gryxay/Rover/doc/presentations/presentation_4.pptx

## VILNIUS UNIVERSITY, FACULTY OF MATHEMATICS AND INFORMATICS, INFORMATION TECHNOLOGIES STUDY PROGRAMME

2022-12-01 Rover, VU, MIF

Rover

Done by:
Gabrielius Drungilas
Aistė Grigalūnaitė
Nedas Janušauskas
Adomas Jonavičius
Supervisor: Linas Bukauskas

## Outline

- Problem
- Accomplishments
- New parts
- Current status
- Upcoming goals

2022-12-01 Rover, VU, MIF

## Problems

Problem:
- Uneven turning angles on different surfaces due to slippage
Solution:
- Fixed tracks belt
- Accelerometer / gyroscope sensor and magnetometer

## Accomplishments

- Bought accelerometer / gyroscope sensor
- Bought magnetometer

## New parts

- Currently we are doing testing
Problems
- It is disturbet by the magnetic fields of electronics and batteries.
- Does not always show accurately

## Current Status

- 484 hours spent on the project.
- Working on:
- Calibration and testing of new parts
- Room mapping system
- Computer vision

## Upcoming Goals

- Work on mapping system
- Add fully functional accelerometer / gyroscope sensor and magnetometer.

## THANK YOU FOR YOUR ATTENTION

## QUESTIONS?
