gryxay/Rover/doc/weekly_reports/weekly_report_10.pdf

# Weekly report 10

What was done this week?

- Bought, tested and calibrated a compass.
- Fixed small issues.
- Created project abstract.
- Programming classes with python.
- Developing precise movement while using compass.
- Testing.
- Writing a weekly report ฀.

What issues/risks/blockers do you have?

- Currently, we don’t have any issues.

What is the goal for next week?

- Keep working on object detection / computer vision.
- Keep working on room mapping system.
- Try to fully implement compass to our project.

What is the overall status?

- Green.
