gryxay/Rover/doc/weekly_reports/weekly_report_3.pdf

# Weekly report 3

What was done this week?

- Buying the required hardware.
- Testing the hardware.
- Testing the software.
- Research.
- Project presentation.
- Writing a weekly report ฀

What issues/risks/blockers do you have?

- Currently, we don’t have any issues.

What is the goal for next week?

- The goal for next week is to do more testing of software and hardware.
- Have prototype functions.
- Find possible problems for the future.
- Driving Rover for the first time!

What is the overall status?

- Green.
