gryxay/Rover/doc/weekly_reports/weekly_report_4.pdf

# Weekly report 4

What was done this week?

- Designing the body prototype.
- Began printing robot body.
- Testing the hardware.
- Testing the software.
- Research.
- Writing a weekly report ฀

What issues/risks/blockers do you have?

- Currently, we don’t have any issues.

What is the goal for next week?

- The goal for next week is to do more testing of software and hardware.
- Make a 3D printed body base.
- Driving Rover for the first time!

What is the overall status?

- Green.
