gryxay/Rover/doc/weekly_reports/weekly_report_5.pdf

# Weekly report 5

What was done this week?

- Designing the body part prototypes.
- Testing the hardware.
- Testing the software.
- Research.
- Writing a weekly report ฀

What issues/risks/blockers do you have?

- Currently, we don’t have any issues.

What is the goal for next week?

- The goal for next week is to do more testing of software and hardware.
- Have a moving robot.
- Make 3D models of every part.

What is the overall status?

- Green.
