gryxay/Rover/doc/weekly_reports/weekly_report_6.pdf

# Weekly report 6

What was done this week?

- Designing 3D models of body parts.
- Printing body parts with a 3D printer.
- Assembly of the driving prototype.
- Testing of the drivetrain.
- Testing of the software.
- Writing a weekly report ฀

What issues/risks/blockers do you have?

- Currently, we don’t have any issues.

What is the goal for next week?

The goal for next week is to:

- Make 3D models of sensor and camera mounts.
- Print the models with a 3D printer.
- Solder the required electronic components.
- Work on the software.

What is the overall status?

- Green.
