gryxay/Rover/doc/weekly_reports/weekly_report_9.pdf

# Weekly report 9

What was done this week?

- Created room mapping system.
- Fixed issue with camera.
- Programming classes with python.
- Developing precise movement.
- Testing.
- Writing a weekly report ฀.

What issues/risks/blockers do you have?

- Currently, we don’t have any issues.

What is the goal for next week?

- Keep working on object detection / computer vision.
- Keep working on room mapping system.

What is the overall status?

- Green.
