gryxay/Rover/doc/presentations/presentation_2.pdf

VILNIUS UNIVERSITY, FACULTY OF MATHEMATICS AND INFORMATICS, INFORMATION TECHNOLOGIES STUDY PROGRAMME

Done by:
Gabrielius Drungilas
Aistė Grigalūnaitė
Nedas Janušauskas
Adomas Jonavičius
Supervisor: Linas Bukauskas

### Rover

2022-10-06 Rover, VU, MIF

## Outline

- Introduction of idea and vision
- Project requirements
- Technologies used
- Implementation plan
- Current status
2022-10-06 Rover, VU, MIF | 2

## Introduction of idea and vision

Main capabilities:
- Sensing
- Movement
- Intelligence

Basic Rover structure:
- Raspberry pi
- 3D printed casing
- Various sensors and motors

## Functional requirements

- Free movement
- Movement is decided without user input
- Obstacle detection
- Obstacle avoidance
- Sound signals

## Non-functional requirements

- Robot will be operational until turned off
- Expected battery life – 2 hours
- Easy to operate

## Hardware

6

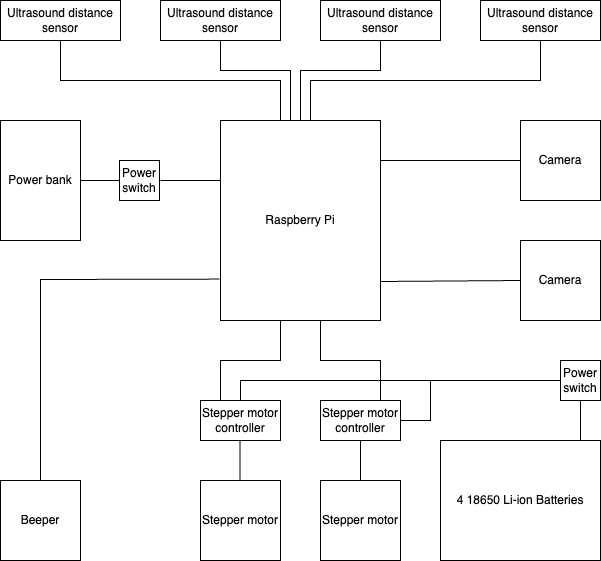
[picture p21: figure]

2022-10-06 Rover, VU, MIF

Figure 1: "Rover" hardware diagram.

## Software

- Linux OS
- Python
- OpenCV
- BASH
- Git
- C++ (Possibly)

## Accomplishments

- Acquired hardware components
- Robot body prototype
- Printed robot base
- Testing hardware

## Current Status

- Hardware assembly
- Robot body modeling/printing
- Deciding on wheel type

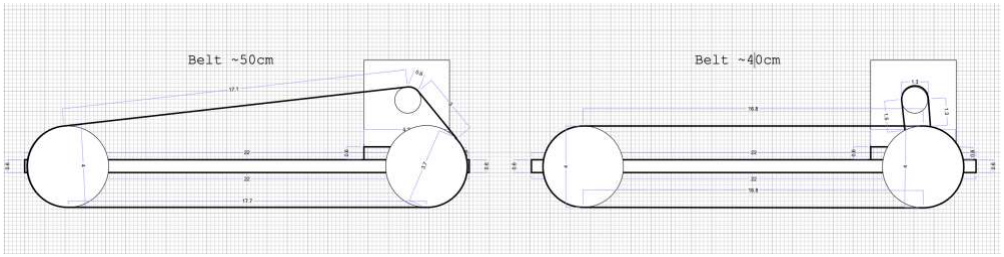
[picture p22: figure]

Figure 2: belt diagram

## Future Goals

- Moving robot

## THANK YOU FOR YOUR ATTENTION

## QUESTIONS?
