gryxay/Rover/doc/weekly_reports/weekly_report_13.pdf

# Weekly report 13

What was done this week?
- Developed mapping and pathing systems.
- Connected robot to a remote controller.
- Prepared presentation for PSI.
- Fixed minor issues.
- Testing.
- Writing a weekly report 😊.
What issues/risks/blockers do you have?
- Currently, we don’t have any issues.
What is the goal for next week?
- Connect computer vision system to the robot.
- Complete the PBL reviewing task, that will be given this week. What is the overall status?
- Green.
