gryxay/Rover/doc/weekly_reports/weekly_report_11.pdf

# Weekly report 11

What was done this week?

- Developed precise robot movement.
- Created Jira accounts.
- Split the tasks.
- Fixed minor issues.
- Programed classes with python.
- Testing.
- Writing a weekly report ฀.

What issues/risks/blockers do you have?

- Currently, we don’t have any issues.

What is the goal for next week?

- Keep working on object detection / computer vision.
- Keep working on room mapping system.
- Complete the PBL task that will be given this week.

What is the overall status?

- Green.
