gryxay/Rover/doc/presentations/Rover_presentation_gabrielius.pdf

VILNIUS UNIVERSITY, FACULTY OF MATHEMATICS AND INFORMATICS, INFORMATION TECHNOLOGIES STUDY PROGRAMME

Done by:
Gabrielius Drungilas
Aistė Grigalūnaitė
Nedas Janušauskas
Adomas Jonavičius
Supervisor: Linas Bukauskas

## Rover

2022-12-15 Rover, VU, MIF

## Outline

- Project introduction
- Updates
- New functionality
- Current status
2022-12-15 Rover, VU, MIF | 2

## Project introduction

The goal of the project is to design an autonomous robot, which would be able to map, detect and avoid objects in an indoor environment.

## Updates

- Accelerometer/Gyroscope functionality
- Increased current in motors
- Sensing system

## Updates: sensing system

Before:
- Distance is calculated on call
- Value calculated on single measurement
- Readings can be unreliable

After:
- Distance is calculated constantly
- Value is calculated as moving average of measurements
- Reading are more reliable

1. set array to [0, 0, 0, 0, 0]
2.
3. function update_array(value)
4. shift all elements in array by one element to the left
5. set last element in array to value
6.
7. function get_distance()
8. return average(array)

## Updates: sensing system

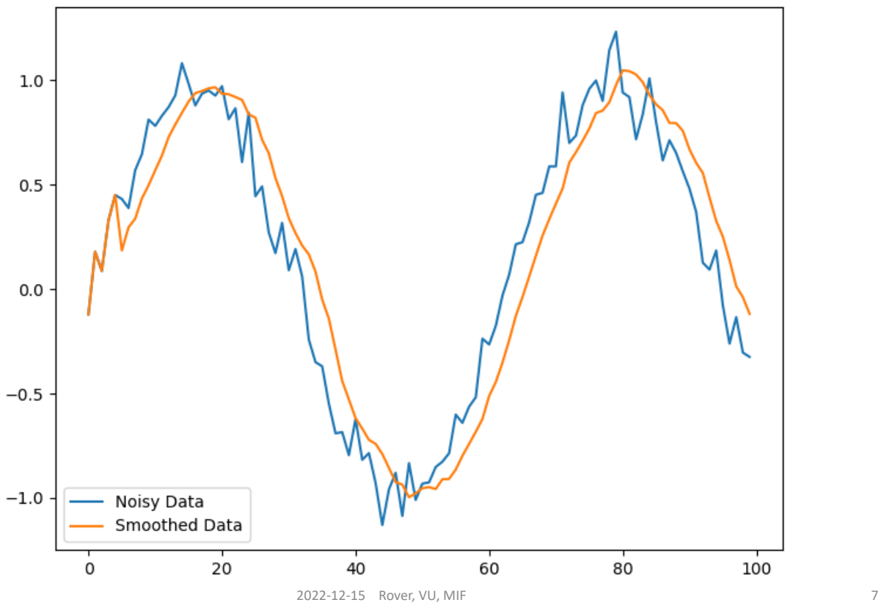
[picture p24: page 7]

## New functionality

- Path-finding algorithm
- Exploring algorithm

## New functionality: Path-finding

A pathfinding algorithm to find the shortest path between the start and end on a map.
Algorithm:
Recursively calculates the distances from the start tile to all adjacent tiles eventually reaching all reachable tiles on the map. If the end is reachable, we add tiles to the path and get the next tile by checking the neighboring tile's distances to start.
In the end, we reach the start and reverse path to get the correct order.

## New functionality: Path-finding

1. Function get_shortest_path() returns List[Tile]:
2. path = []
3. if start is not set or end is not set:
4. return path
5. start_tile = map[start]
6. end_tile = map[end]
7. start_tile.distance = 0
8. calculate_distances(start_tile)
9. if end_tile.distance is None:
10. return path
11. cur_tile = end_tile
12. for _ in range(cur_tile.distance):
13. path.append(cur_tile)
14. cur_tile = get_lowest_distance_neighbour(cur_tile)
15. return reversed path

## New functionality: Path-finding

Example:
S - start, E - end, # - obstacle, N – distance is None, number – distance from the start
Before: | After:

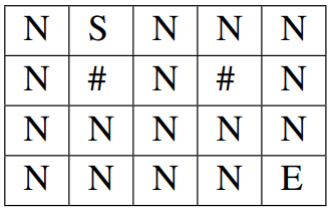
[picture p25: figure]
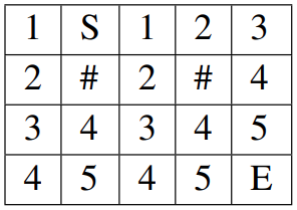
[picture p26: figure]

## New functionality: Exploring

Built the code base for further development of exploring tactics. 2 types of implemented exploring tactics:
- Ride while possible, if not turn in random available direction.
- Ride straight until robot finds wall, then ride among the wall, following its every turn.

## New functionality: Exploring

Real map of first tactic:

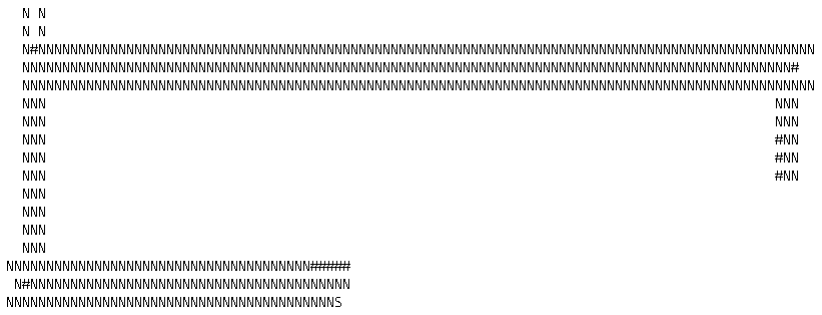
[picture p27: figure]

## Current status

Total hours spent on project: 632
Current tasks:
- Thoroughly test new exploring tactics.
- Build more complex, fool proof exploring tactics.
- Reposition distance sensors for better visibility.

## THANK YOU FOR YOUR ATTENTION

2022-12-15 Rover, VU, MIF

## Extra

1. Function calculate_distances(Tile tile, int n=0) returns None:
2. neighbours = get_neighbours(tile)
3. for i in range(len(neighbours)):
4. if neighbours[i] is an obstacle or is unknown:
5. continue
6. elif neighbours[i].distance is None or neighbours[i].distance > n + 1:
7. neighbours[i].distance = n + 1
8. if neighbours[i] is the end:
9. break
10. calculate_distances(neighbours[i], n + 1)

16
