gryxay/Rover/doc/diagrams/deployment_diagram.pdf

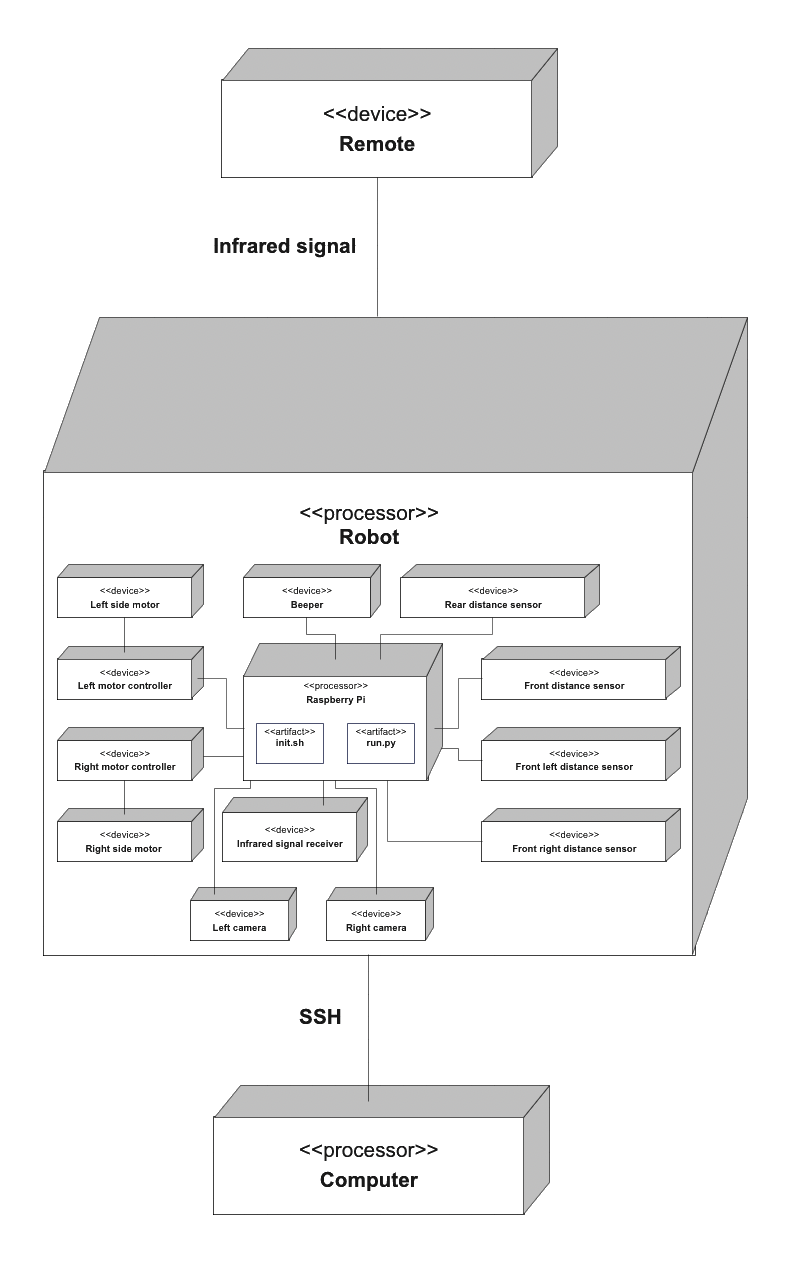
[picture p28: page 1]
