gryxay/Rover/doc/diagrams/drivetrain_diagram.png

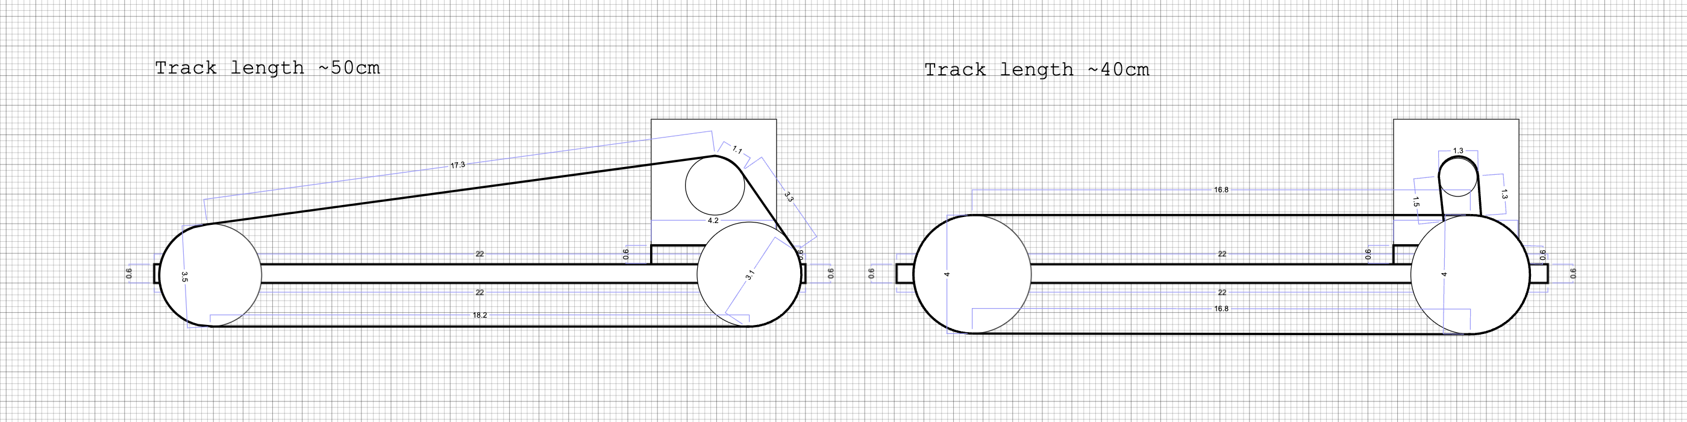
doc/diagrams/drivetrain_diagram.png
