gryxay/Rover/doc/diagrams/Map.check_corners_for_obstacles.png

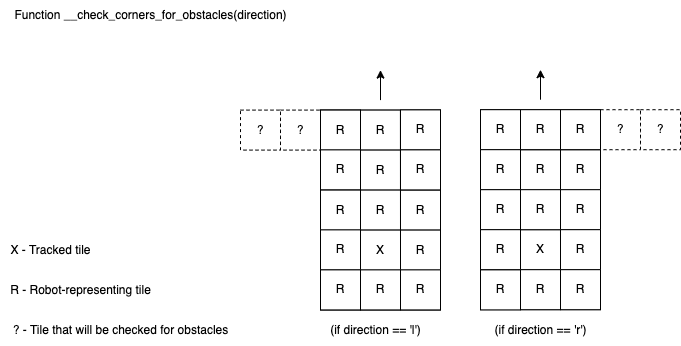
doc/diagrams/Map.check_corners_for_obstacles.png
