gryxay/Rover/doc/diagrams/Map.check_for_obstacles.png

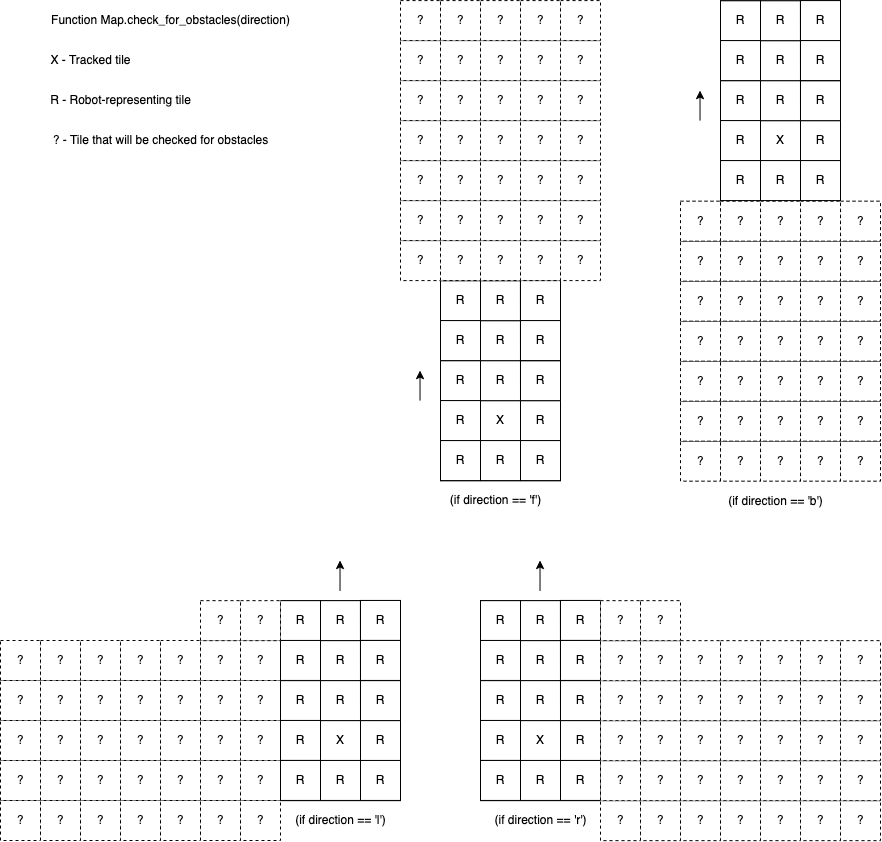
doc/diagrams/Map.check_for_obstacles.png
