gryxay/Rover/doc/diagrams/position_tracking.png

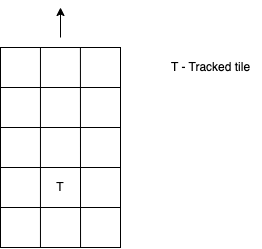
doc/diagrams/position_tracking.png
