gryxay/Rover/doc/diagrams/remote_button_codes.png

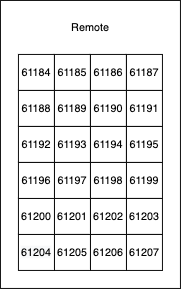
doc/diagrams/remote_button_codes.png
