gryxay/Rover/doc/CAD/prototypes/battery_holder_mount/battery_holder_mount.stl

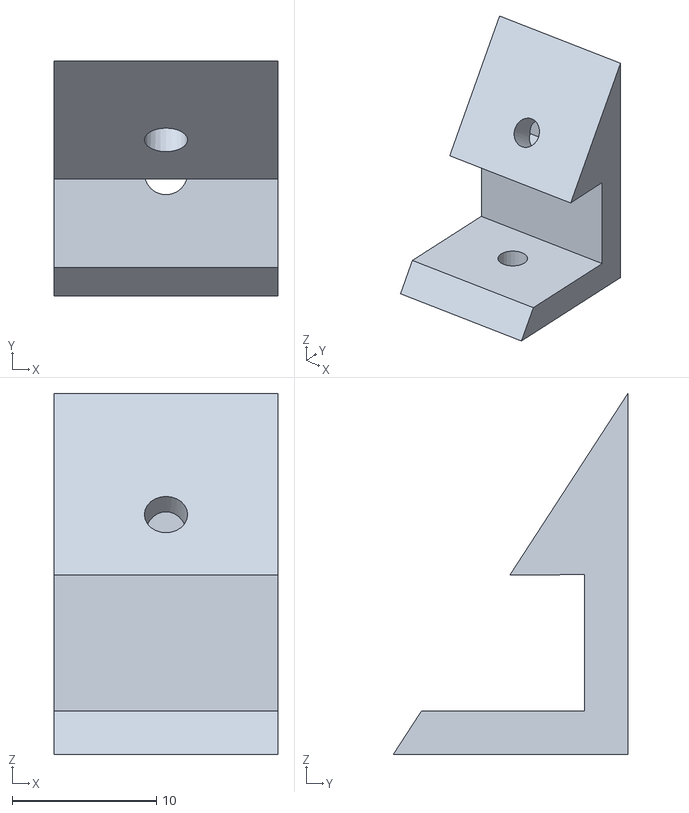
[picture p34: CAD file, 2022-11-06]
doc/CAD/prototypes/battery_holder_mount/battery_holder_mount.stl
15.5 x 16.3 x 25.0
