gryxay/Rover/doc/CAD/prototypes/camera_mount/b/camera_mount_b.stl

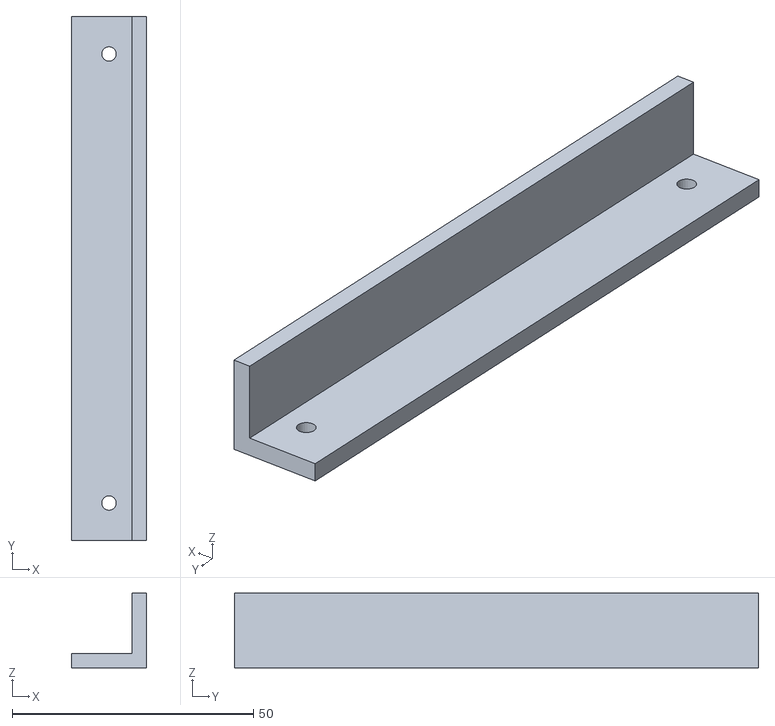
[picture p35: CAD file, 2022-11-06]
doc/CAD/prototypes/camera_mount/b/camera_mount_b.stl
15.5 x 108.5 x 15.5
