gryxay/Rover/doc/CAD/prototypes/distance_sensor_mounts/front_left_sensor_mount/front_left_sensor_mount.stl

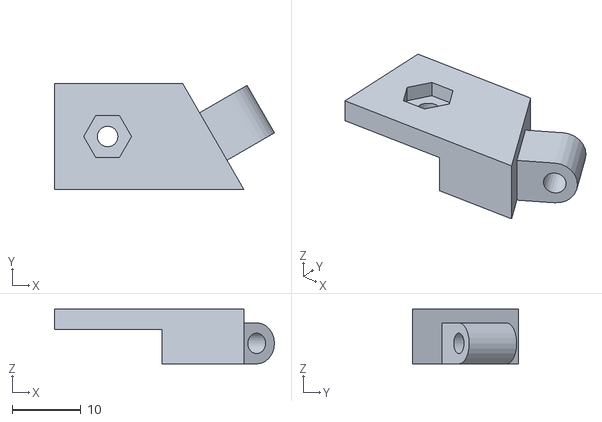
[picture p36: CAD file, 2022-11-04]
doc/CAD/prototypes/distance_sensor_mounts/front_left_sensor_mount/front_left_sensor_mount.stl
32.1 x 15.5 x 8.00
