gryxay/Rover/doc/CAD/prototypes/distance_sensor_mounts/sensor_case/sensor_case.stl

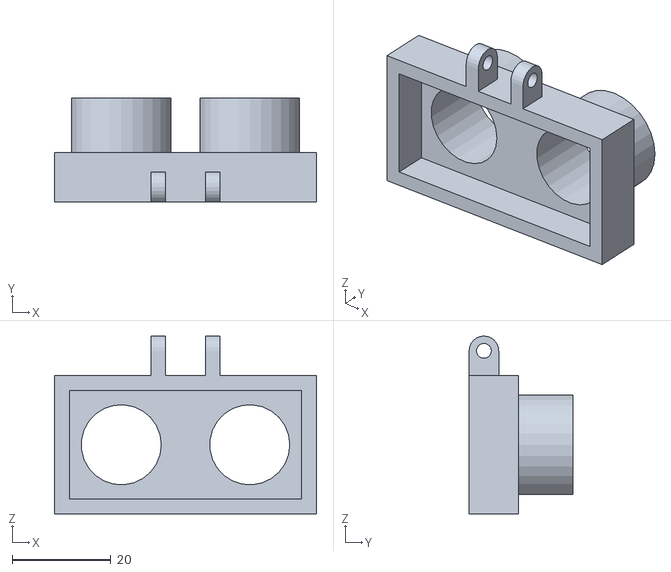
[picture p37: CAD file, 2022-11-04]
doc/CAD/prototypes/distance_sensor_mounts/sensor_case/sensor_case.stl
53.0 x 21.0 x 36.0
