gryxay/Rover/doc/CAD/prototypes/distance_sensor_mounts/sensor_mount/sensor_mount.stl

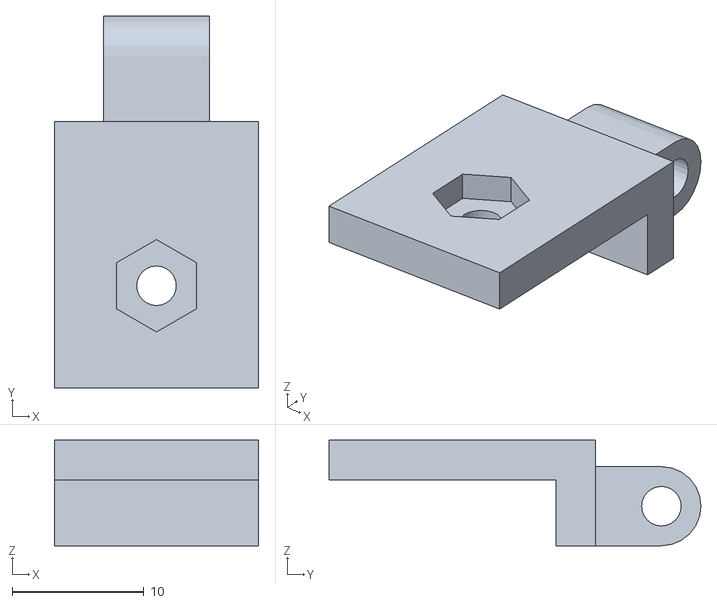
[picture p38: CAD file, 2022-11-04]
doc/CAD/prototypes/distance_sensor_mounts/sensor_mount/sensor_mount.stl
15.5 x 28.2 x 8.00
