gryxay/Rover/doc/CAD/prototypes/front_wheel_mount/left_side/front_wheel_mount_left_v4.stl

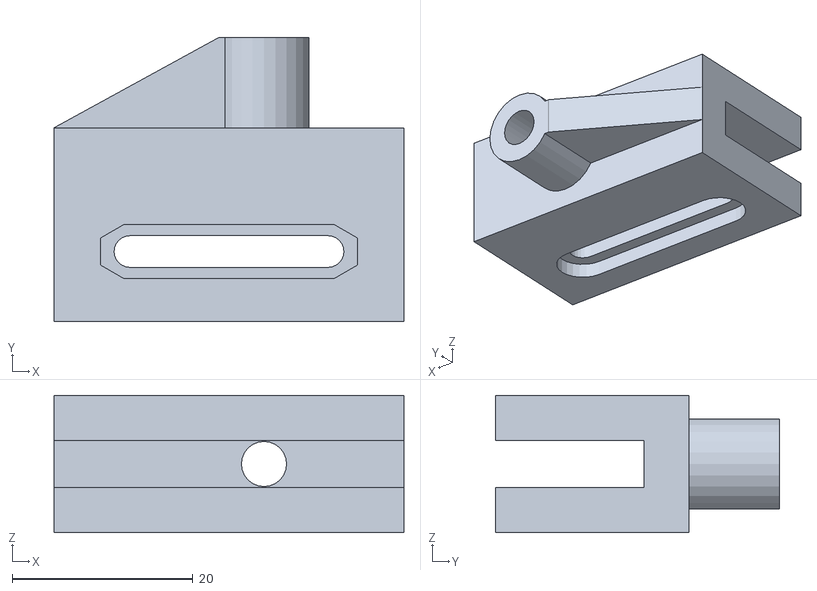
[picture p39: CAD file, 2022-11-02]
doc/CAD/prototypes/front_wheel_mount/left_side/front_wheel_mount_left_v4.stl
38.7 x 31.4 x 15.2
