gryxay/Rover/doc/CAD/prototypes/geared_wheel/gear_test_v2/gear_test_v2.stl

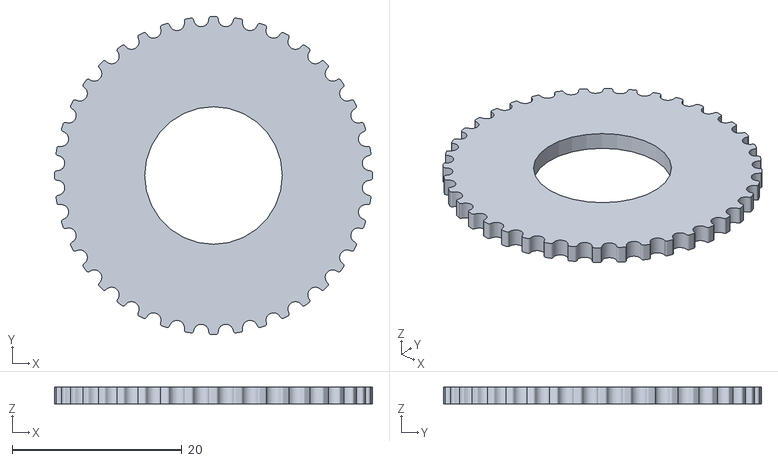
[picture p40: CAD file, 2022-10-27]
doc/CAD/prototypes/geared_wheel/gear_test_v2/gear_test_v2.stl
37.4 x 37.4 x 2.00
