gryxay/Rover/doc/CAD/prototypes/motor_controller_mount/motor_controller_mount.stl

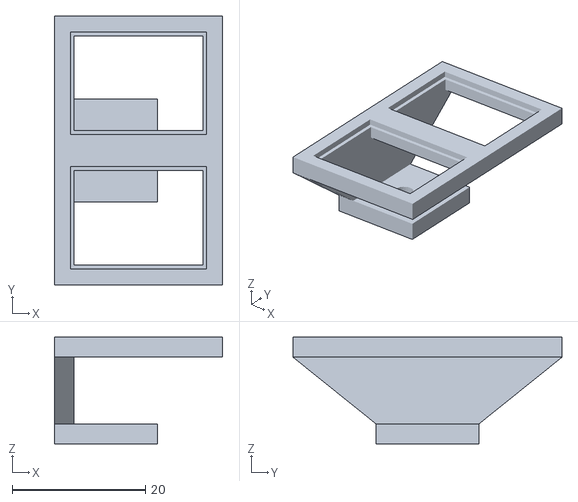
[picture p41: CAD file, 2022-11-06]
doc/CAD/prototypes/motor_controller_mount/motor_controller_mount.stl
25.3 x 40.4 x 16.0
