gryxay/Rover/doc/CAD/prototypes/motor_mount/v2/right_side/motor_mount_right_v2.stl

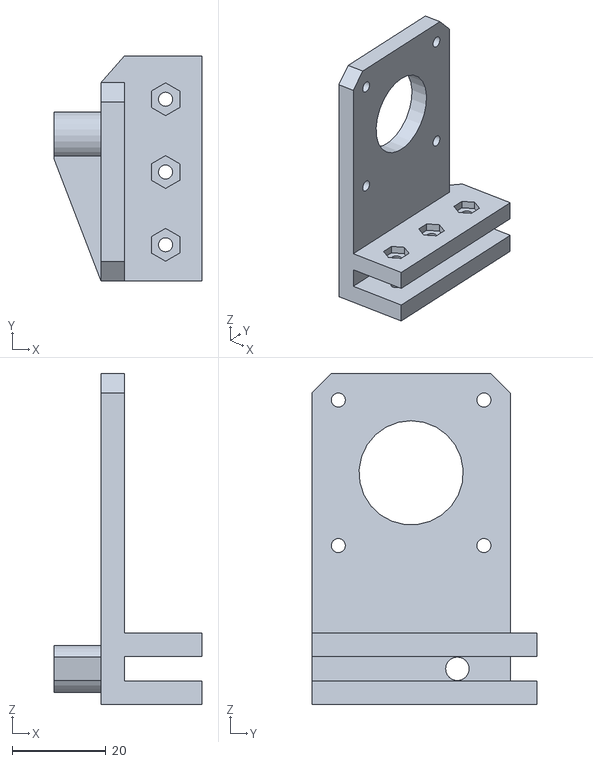
[picture p43: CAD file, 2022-11-02]
doc/CAD/prototypes/motor_mount/v2/right_side/motor_mount_right_v2.stl
31.5 x 48.0 x 70.5
