gryxay/Rover/doc/CAD/prototypes/power_switch_case/power_switch_case.stl

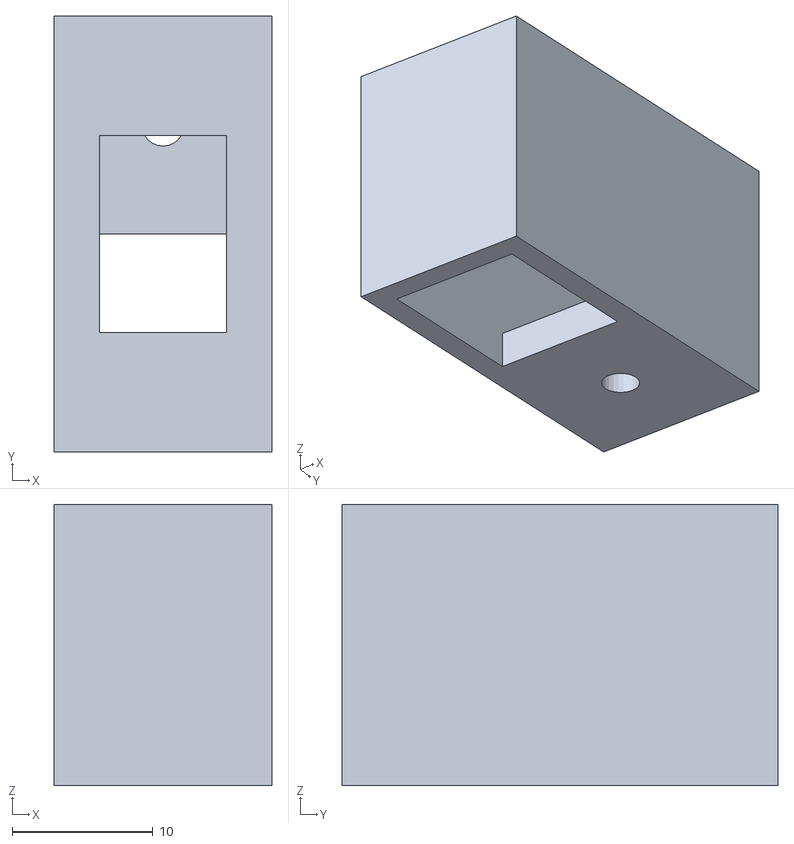
[picture p44: CAD file, 2022-11-06]
doc/CAD/prototypes/power_switch_case/power_switch_case.stl
15.5 x 31.0 x 20.0
