gryxay/Rover/doc/CAD/prototypes/wheel_mounts/front_wheel_mount_v3/left_side/front_wheel_mount_sketch_v2.stl

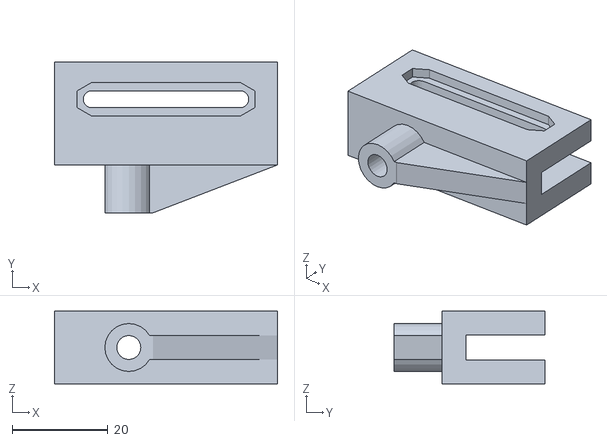
[picture p45: CAD file, 2022-11-02]
doc/CAD/prototypes/wheel_mounts/front_wheel_mount_v3/left_side/front_wheel_mount_sketch_v2.stl
46.5 x 31.4 x 15.2
