gryxay/Rover/doc/CAD/prototypes/wheel_mounts/rear_wheel_mount_v1/rear_wheel_mount_v1.stl

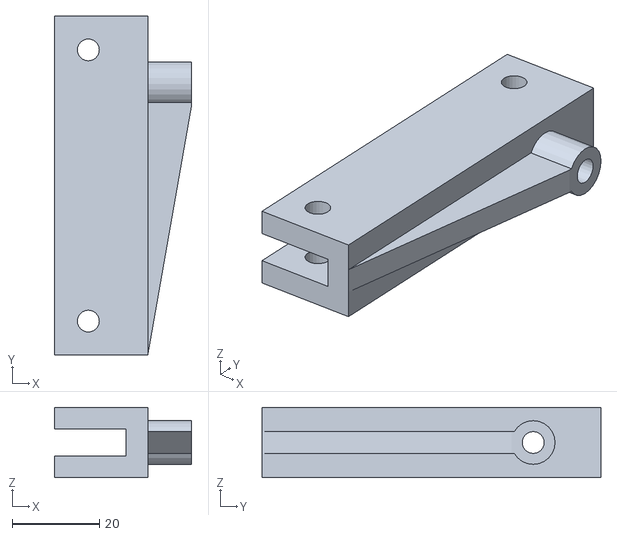
[picture p46: CAD file, 2022-10-24]
doc/CAD/prototypes/wheel_mounts/rear_wheel_mount_v1/rear_wheel_mount_v1.stl
31.3 x 77.5 x 16.1
