gryxay/Rover/doc/CAD/final/distance_sensor_mounts/side_sensor_mounts/right_sensor_mount.stl

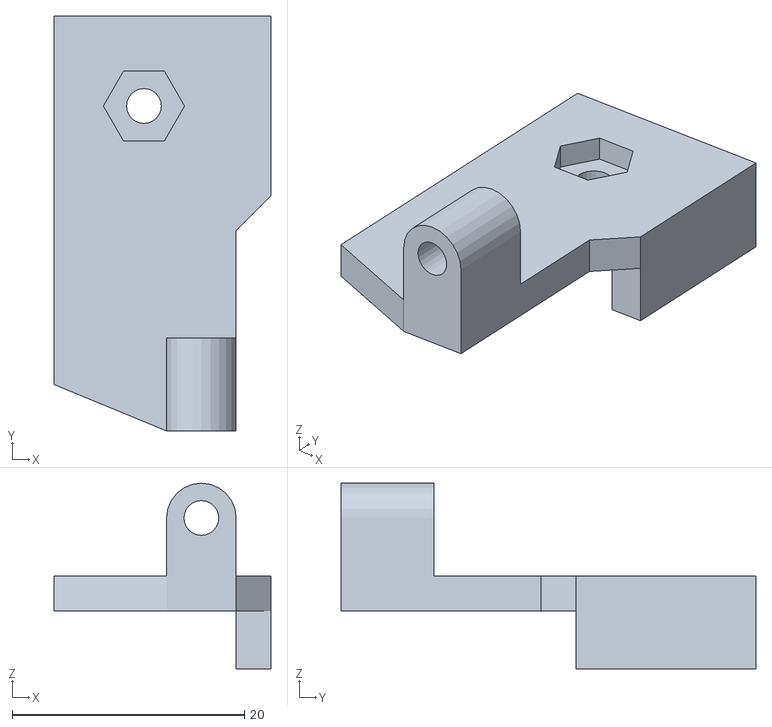
[picture p47: CAD file, 2022-12-16]
doc/CAD/final/distance_sensor_mounts/side_sensor_mounts/right_sensor_mount.stl
18.7 x 35.8 x 16.0
