gryxay/Rover/doc/CAD/prototypes/base_plate/v1/base_plate_v1.stl

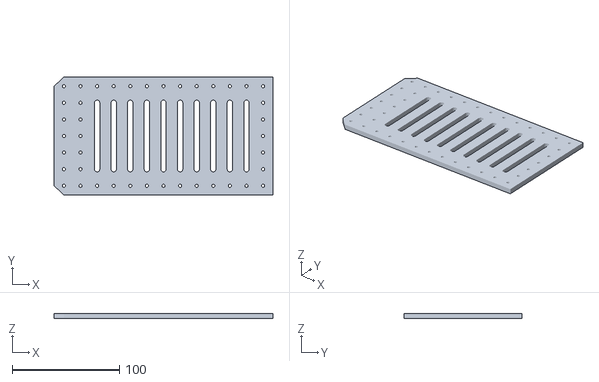
[picture p48: CAD file, 2022-10-28]
doc/CAD/prototypes/base_plate/v1/base_plate_v1.stl
204.5 x 110.0 x 5.00
