gryxay/Rover/doc/CAD/prototypes/camera_mount/a/camera_mount_a.stl

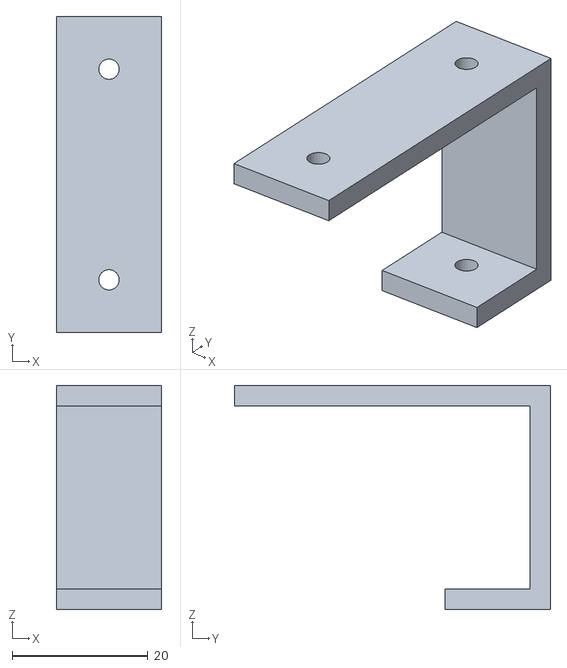
[picture p49: CAD file, 2022-11-22]
doc/CAD/prototypes/camera_mount/a/camera_mount_a.stl
15.5 x 46.5 x 33.0
