gryxay/Rover/doc/CAD/prototypes/computer_plate/v1/computer_plate.stl

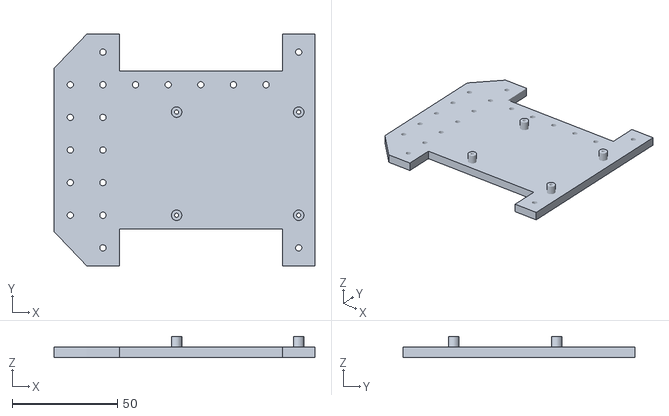
[picture p50: CAD file, 2022-11-02]
doc/CAD/prototypes/computer_plate/v1/computer_plate.stl
124.0 x 110.0 x 10.00
