gryxay/Rover/doc/CAD/prototypes/geared_wheel/geared_wheel_v4/geared_wheel_v4.stl

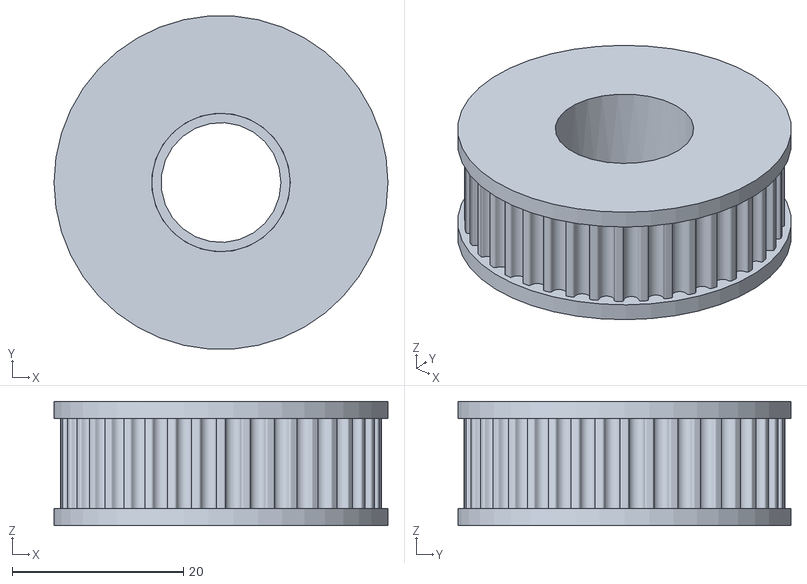
[picture p51: CAD file, 2022-10-27]
doc/CAD/prototypes/geared_wheel/geared_wheel_v4/geared_wheel_v4.stl
39.0 x 38.9 x 14.5
