gryxay/Rover/doc/CAD/prototypes/power_bank_holder/a/power_bank_holder_a_v1.stl

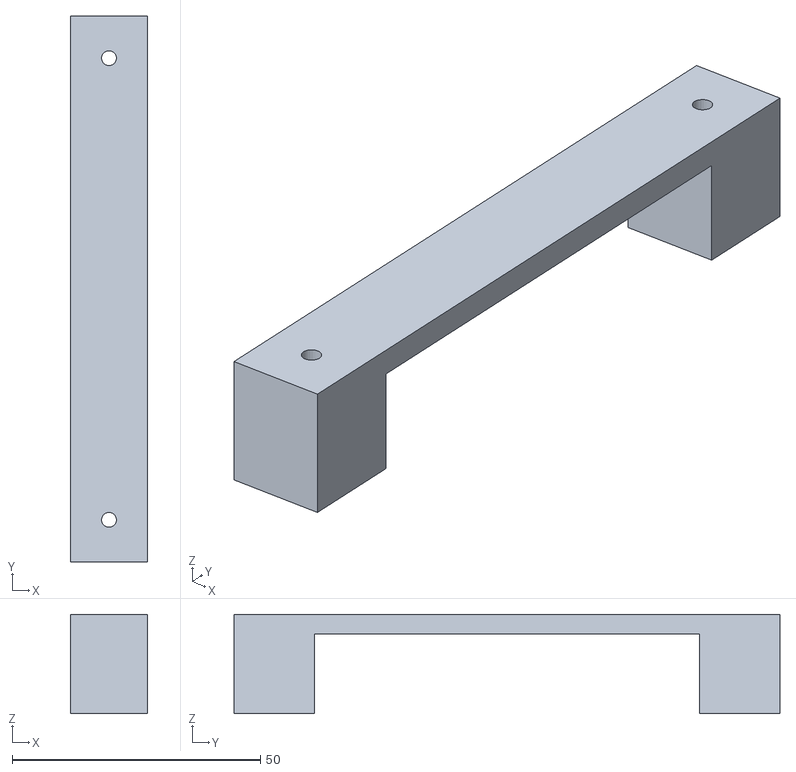
[picture p52: CAD file, 2022-11-02]
doc/CAD/prototypes/power_bank_holder/a/power_bank_holder_a_v1.stl
15.5 x 110.0 x 20.0
