gryxay/Rover/(list of files, cad)

Other CAD files:
doc/CAD/final/distance_sensor_mounts/side_sensor_mounts/side_sensor_mounts.dwg
doc/CAD/prototypes/base_plate/v1/base_plate_sketch_v1.dwg
doc/CAD/prototypes/camera_mount/a/camera_mount_sketch_a.dwg
doc/CAD/prototypes/computer_plate/v1/computer_plate_sketch_v1.dwg
doc/CAD/prototypes/distance_sensor_mounts/front_right_sensor_mount/front_right_sensor_mount.stl
doc/CAD/prototypes/front_wheel_mount/right_side/front_wheel_mount_right_v4.stl
doc/CAD/prototypes/geared_wheel/geared_wheel_v4/geared_wheel_sketch_v4.dwg
doc/CAD/prototypes/power_bank_holder/a/power_bank_holder_sketch_a_v1.dwg
doc/CAD/prototypes/power_bank_holder/b/power_bank_holder_sketch_b_v1.dwg
doc/CAD/prototypes/wheel_mounts/front_wheel_mount_v3/right_side/front_wheel_mount_v3.stl
doc/CAD/prototypes/battery_holder_mount/battery_holder_mount_sketch.dwg
doc/CAD/prototypes/camera_mount/b/camera_mount_sketch_b.dwg
doc/CAD/prototypes/motor_controller_mount/motor_controller_mount_sketch.dwg
doc/CAD/prototypes/motor_mount/v2/left_side/motor_mount_sketch_left_v2.dwg
doc/CAD/prototypes/motor_mount/v2/right_side/motor_mount_sketch_right_v2.dwg
doc/CAD/prototypes/power_switch_case/power_switch_case_sketch.dwg
doc/CAD/prototypes/wheel_mounts/front_wheel_mount_v3/left_side/front_wheel_mount_sketch_v3.dwg
doc/CAD/prototypes/wheel_mounts/front_wheel_mount_v3/right_side/front_wheel_mount_sketch_v3.dwg
doc/CAD/prototypes/wheel_mounts/rear_wheel_mount_v1/rear_wheel_mount_sketch_v1.dwg
doc/CAD/final/distance_sensor_mounts/side_sensor_mounts/left_sensor_mount.stl
doc/CAD/prototypes/distance_sensor_mounts/front_left_sensor_mount/front_left_sensor_mount.dwg
doc/CAD/prototypes/distance_sensor_mounts/front_right_sensor_mount/front_right_sensor_mount.dwg
doc/CAD/prototypes/distance_sensor_mounts/sensor_case/sensor_case.dwg
doc/CAD/prototypes/distance_sensor_mounts/sensor_mount/sensor_mount.dwg
doc/CAD/prototypes/geared_wheel/gear_test_v2/gear_test_v2.dwg
doc/CAD/prototypes/geared_wheel/geared_wheel_v1/gearded_wheel_v1.stl
doc/CAD/prototypes/geared_wheel/geared_wheel_v1/geared_wheel_sketch_v1.dwg
doc/CAD/prototypes/geared_wheel/geared_wheel_v2/geared_wheel_sketch_v2.dwg
doc/CAD/prototypes/geared_wheel/geared_wheel_v2/geared_wheel_v2.stl
doc/CAD/prototypes/geared_wheel/geared_wheel_v3/geared_wheel_sketch_v3.dwg
doc/CAD/prototypes/geared_wheel/geared_wheel_v3/geared_wheel_v3.stl
doc/CAD/prototypes/motor_mount/v1/motor_mount_3d_v1.stl
doc/CAD/prototypes/motor_mount/v1/motor_mount_sketch_v1.dwg
doc/CAD/prototypes/wheel_mounts/front_wheel_mount_v1/front_wheel_mount_sketch_v1.dwg
doc/CAD/prototypes/wheel_mounts/front_wheel_mount_v1/front_wheel_mount_v1.stl
doc/CAD/prototypes/wheel_mounts/front_wheel_mount_v2/front_wheel_mount_sketch_v2.dwg
doc/CAD/prototypes/wheel_mounts/front_wheel_mount_v2/front_wheel_mount_v2.stl
