gryxay/Rover/src/tests/compass/test_2/calibration_results_graphs/calibration_results_1.png

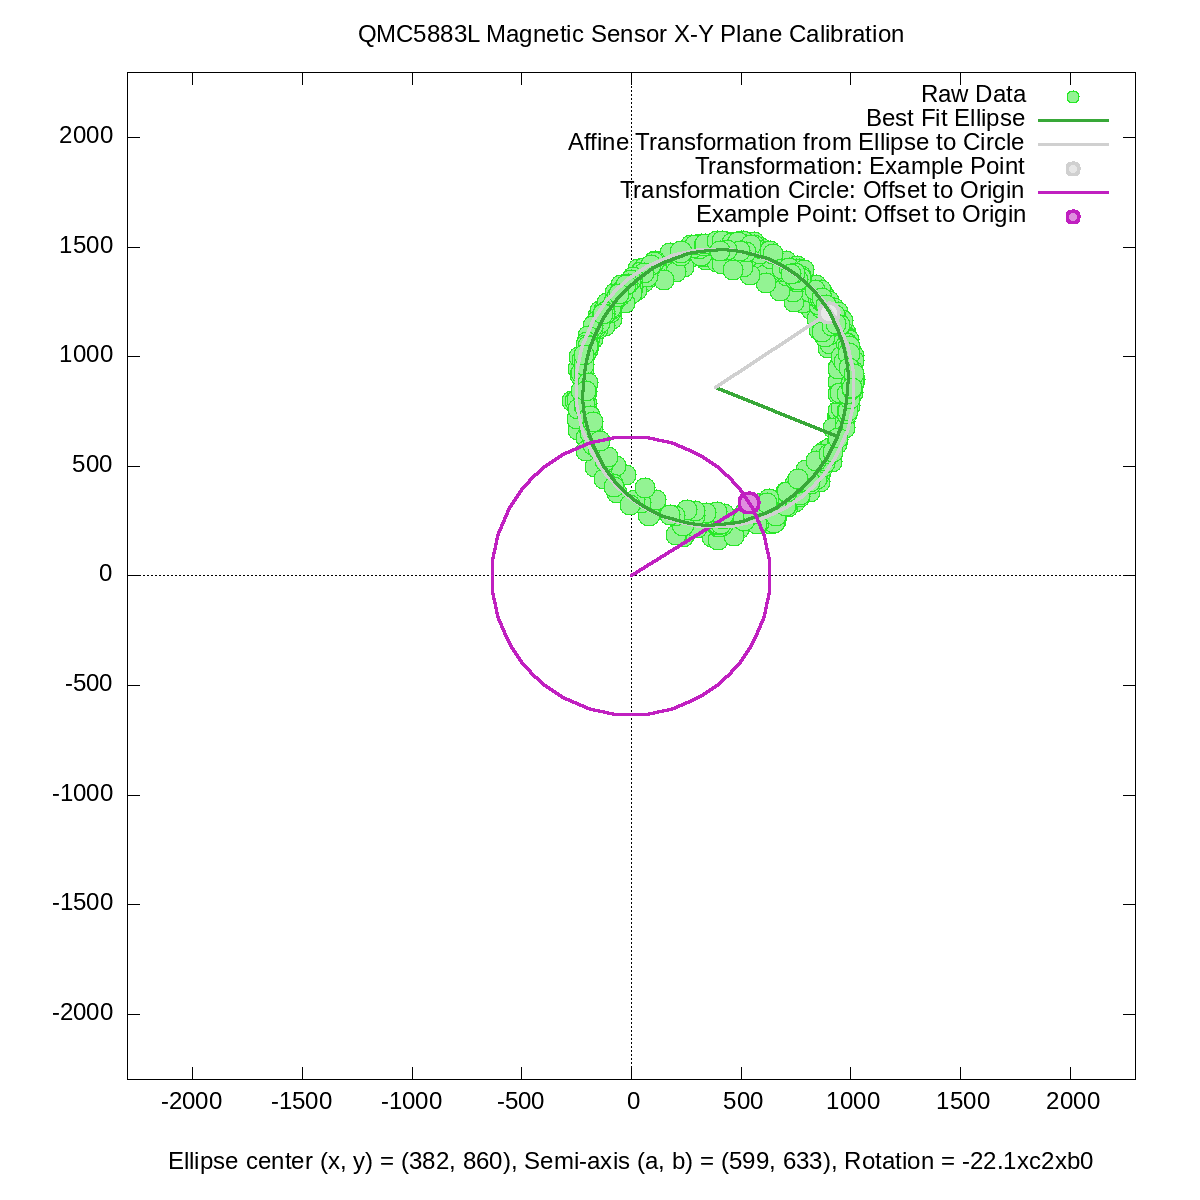
src/tests/compass/test_2/calibration_results_graphs/calibration_results_1.png
