gryxay/Rover/src/tests/compass/test_2/calibration_results_graphs/calibration_results_2.png

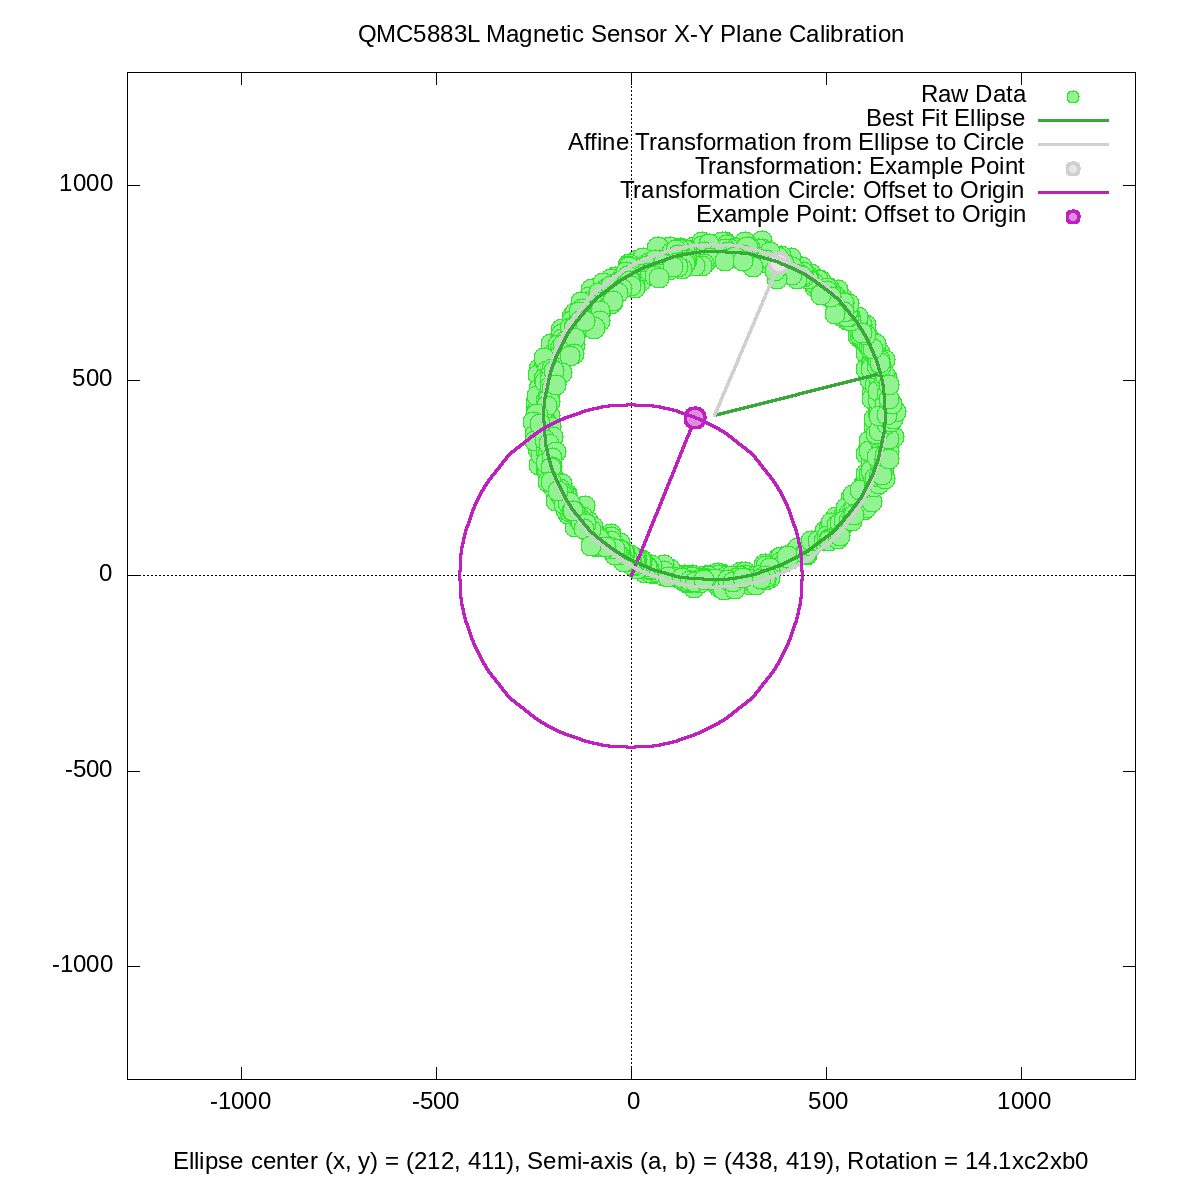
src/tests/compass/test_2/calibration_results_graphs/calibration_results_2.png
