gryxay/Rover/doc/diagrams/context_diagram.pdf

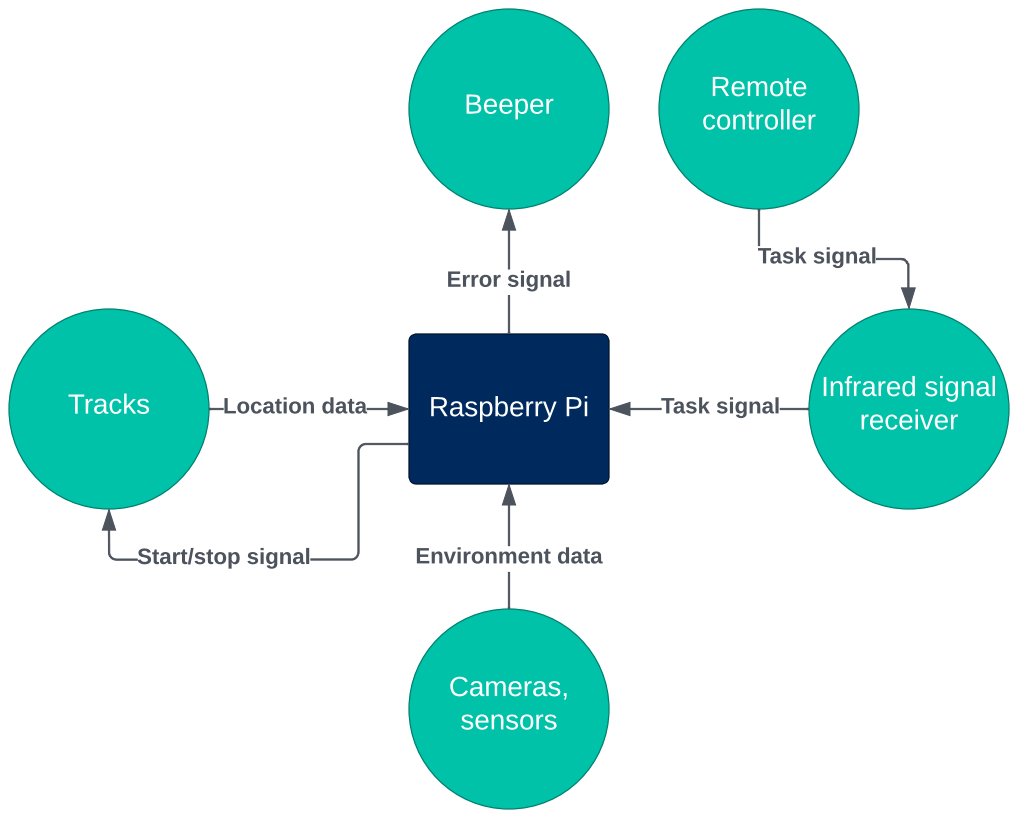
[picture p56: page 1]
Raspberry Pi; Cameras, sensors; Tracks; Beeper; Infrared signal receiver; Location data; Start/stop signal; Environment data; Task signal; Error signal; Remote controller
