gryxay/Rover/src/deployed_version/python3.11/Constants.py

class Buzzer_Constants:
    TRIG_PIN = 5

    # "Name": (cycles, beeps per cycle, beep duration, time between cycles)
    SOUND_SIGNALS = {
        "Loading": (1, 1, 0.1, 0),
        "Cancelling": (3, 2, 0.05, 0.1),
        "Ready": (1, 3, 0.1, 0),
        "Stuck": (1, 3, 1, 0),
        "Error": (1, 1, 2, 0),
        "Sensing System": (3, 1, 0.5, 2),
        "IMU": (3, 2, 0.5, 2),
        "Computer Vision": (3, 3, 0.5, 2),
        "IR Receiver": (3, 4, 0.5, 2)
    }

    NOTES = {
        "C0": 16,
        "C#0": 17,
        "D0": 18,
        "D#0": 19,
        "E0": 21,
        "F0": 22,
        "F#0": 23,
        "G0": 24,
        "G#0": 26,
        "A0": 28,
        "A#0": 29,
        "B0": 31,
        "C1": 33,
        "C#1": 35,
        "D1": 37,
        "D#1": 39,
        "E1": 41,
        "F1": 44,
        "F#1": 46,
        "G1": 49,
        "G#1": 52,
        "A1": 55,
        "A#1": 58,
        "B1": 62,
        "C2": 65,
        "C#2": 69,
        "D2": 73,
        "D#2": 78,
        "E2": 82,
        "F2": 87,
        "F#2": 92,
        "G2": 98,
        "G#2": 104,
        "A2": 110,
        "A#2": 117,
        "B2": 123,
        "C3": 131,
        "C#3": 139,
        "D3": 147,
        "D#3": 156,
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
    }

    SONGS = {
        "Exploring": [
            ("C4", 0.125), ("C5", 0.125), ("A3", 0.125), ("A4", 0.125),
            ("A#3", 0.125), ("A#4", 0.125), (None, 0.625), (None, 0.3125)
        ],
        "Found it!": [
        ("C4", 0.0625), ("D4", 0.0625), ("E4", 0.0625), (None, 0.0625),
        ("C4", 0.0625), ("D4", 0.0625), ("E4", 0.0625), (None, 0.0625),
        ("C4", 0.0625), ("D4", 0.0625), ("E4", 0.0625), (None, 0.0625),
        (None, 0.25),
        ("C4", 0.0625), ("D4", 0.0625), ("E4", 0.0625), (None, 0.0625),
        ("C4", 0.0625), ("D4", 0.0625), ("E4", 0.0625), (None, 0.0625),
        ("C4", 0.0625), ("D4", 0.0625), ("E4", 0.0625), (None, 0.0625),
        (None, 0.25),
        ("C4", 0.0625), ("D4", 0.0625), ("E4", 0.0625), (None, 0.0625),
        ("C4", 0.0625), ("D4", 0.0625), ("E4", 0.0625), (None, 0.0625),
        ("C4", 0.0625), ("D4", 0.0625), ("E4", 0.0625), (None, 0.0625),
        (None, 0.25)
        ],
        "Mario underworld": [
            ("C4", 0.125), ("C5", 0.125), ("A3", 0.125), ("A4", 0.125), 
            ("A#3", 0.125), ("A#4", 0.125), (None, 0.625), (None, 0.3125),
            ("C4", 0.125), ("C5", 0.125), ("A3", 0.125), ("A4", 0.125), 
            ("A#3", 0.125), ("A#4", 0.125), (None, 0.625), (None, 0.3125),
            ("F3", 0.125), ("F4", 0.125), ("D3", 0.125), ("D4", 0.125), 
            ("D#3", 0.125), ("D#4", 0.125), (None, 0.625), (None, 0.3125),
            ("F3", 0.125), ("F4", 0.125), ("D3", 0.125), ("D4", 0.125), 
            ("D#3", 0.125), ("D#4", 0.125), (None, 0.625), (None, 0.625)
        ],
        "He's a Pirate": [
        ("E4", 0.125), ("G4", 0.125), ("A4", 0.25), ("A4", 0.125), 
        (None, 0.125), ("A4", 0.125), ("B4", 0.125), ("C5", 0.25), 
        ("C5", 0.125), (None, 0.125), ("C5", 0.125), ("D5", 0.125), 
        ("B4", 0.25), ("B4", 0.125), (None, 0.125), ("A4", 0.125), 
        ("G4", 0.125), ("A4", 0.375), (None, 0.125), ("E4", 0.125), 
        ("G4", 0.125), ("A4", 0.25), ("A4", 0.125), (None, 0.125), 
        ("A4", 0.125), ("B4", 0.125), ("C5", 0.25), ("C5", 0.125),
        (None, 0.125), ("C5", 0.125), ("D5", 0.125), ("B4", 0.25),
        ("B4", 0.125), (None, 0.125), ("A4", 0.125), ("G4", 0.125), 
        ("A4", 0.375), (None, 0.125), ("E4", 0.125), ("G4", 0.125), 
        ("A4", 0.25), ("A4", 0.125), (None, 0.125), ("A4", 0.125), 
        ("C5", 0.125), ("D5", 0.25), ("D5", 0.125), (None, 0.125), 
        ("D5", 0.125), ("E5", 0.125), ("F5", 0.25), ("F5", 0.125), 
        (None, 0.125), ("E5", 0.125), ("D5", 0.125), ("E5", 0.125), 
        ("A4", 0.25), (None, 0.125), ("A4", 0.125), ("B4", 0.125), 
        ("C5", 0.25), ("C5", 0.125), (None, 0.125), ("D5", 0.25), 
        ("E5", 0.125), ("A4", 0.25), (None, 0.125), ("A4", 0.125), 
        ("C5", 0.125), ("B4", 0.25), ("B4", 0.125), (None, 0.125), 
        ("C5", 0.125), ("A4", 0.125), ("B4", 0.375), (None, 0.375), 
        ("A4", 0.25), ("A4", 0.125), ("A4", 0.125), ("B4", 0.125), 
        ("C5", 0.25), ("C5", 0.125), (None, 0.125), ("C5", 0.125), 
        ("D5", 0.125), ("B4", 0.25), ("B4", 0.125), (None, 0.125), 
        ("A4", 0.125), ("G4", 0.125), ("A4", 0.375), (None, 0.125),
        ("E4", 0.125), ("G4", 0.125), ("A4", 0.25), ("A4", 0.125), 
        (None, 0.125), ("A4", 0.125), ("B4", 0.125), ("C5", 0.25), 
        ("C5", 0.125), (None, 0.125), ("C5", 0.125), ("D5", 0.125), 
        ("B4", 0.25), ("B4", 0.125), (None, 0.125), ("A4", 0.125), 
        ("G4", 0.125), ("A4", 0.375), (None, 0.125), ("E4", 0.125), 
        ("G4", 0.125), ("A4", 0.25), ("A4", 0.125), (None, 0.125), 
        ("A4", 0.125), ("C5", 0.125), ("D5", 0.25), ("D5", 0.125), 
        (None, 0.125), ("D5", 0.125), ("E5", 0.125), ("F5", 0.25), 
        ("F5", 0.125), (None, 0.125), ("E5", 0.125), ("D5", 0.125), 
        ("E5", 0.125), ("A4", 0.25), (None, 0.125), ("A4", 0.125), 
        ("B4", 0.125), ("C5", 0.25), ("C5", 0.125), (None, 0.125), 
        ("D5", 0.25), ("E5", 0.125), ("A4", 0.25), (None, 0.125), 
        ("A4", 0.125), ("C5", 0.125), ("B4", 0.25), ("B4", 0.125), 
        (None, 0.125), ("C5", 0.125), ("A4", 0.125), ("B4", 0.375), 
        (None, 0.375), ("E5", 0.25), (None, 0.125), (None, 0.375), 
        ("F5", 0.25), (None, 0.125), (None, 0.375), ("E5", 0.125), 
        ("E5", 0.125), (None, 0.125), ("G5", 0.125), (None, 0.125), 
        ("E5", 0.125), ("D5", 0.125), (None, 0.125), (None, 0.375), 
        ("D5", 0.25), (None, 0.125), (None, 0.375), ("C5", 0.25), 
        (None, 0.125), (None, 0.375), ("B4", 0.125), ("C5", 0.125), 
        (None, 0.125), ("B4", 0.125), (None, 0.125), ("A4", 0.5), 
        ("E5", 0.25), (None, 0.125), (None, 0.375), ("F5", 0.25), 
        (None, 0.125), (None, 0.375), ("E5", 0.125), ("E5", 0.125), 
        (None, 0.125), ("G5", 0.125), (None, 0.125), ("E5", 0.125), 
        ("D5", 0.125), (None, 0.125), (None, 0.375), ("D5", 0.25), 
        (None, 0.125), (None, 0.375), ("C5", 0.25), (None, 0.125), 
        (None, 0.375), ("B4", 0.125), ("C5", 0.125), (None, 0.125), 
        ("B4", 0.125), (None, 0.125), ("A4", 0.5)
    ]}


class Computer_Vision_Constants:
    IMAGE_WIDTH = 640
    IMAGE_HEIGHT = 480
    MAX_FPS = 15
    LOOP_TIMEOUT = 1 / MAX_FPS

    # Percentage of confidence needed to categorise an object
    MIN_CONFIDENCE = 0.75 # 1 = 100%;

    PROTOTXT_PATH = "models/MobileNetSSD_deploy.prototxt"
    MODEL_PATH = "models/MobileNetSSD_deploy.caffemodel"

    CLASSES = [
        "background", "aeroplane", "bicycle", "bird", "boat",
        "bottle", "bus", "car", "cat", "chair", "cow", "diningtable",
        "dog", "horse", "motorbike", "person", "pottedplant", "sheep",
        "sofa", "train", "tvmonitor", "unknown"
    ]


class Distance_Sensor_Constants:
    # cm
    MAX_READING_DISTANCE = 400

    # cm/s
    SPEED_OF_SOUND = 34300
    HALF_SPEED_OF_SOUND = SPEED_OF_SOUND / 2

    # Values in seconds
    DELAY = 0.01		
    SIGNAL_LENGTH = 0.00001
    TIMEOUT = MAX_READING_DISTANCE / HALF_SPEED_OF_SOUND


class Drivetrain_Constants:
    LEFT_MOTOR_DIR_PIN = 16
    LEFT_MOTOR_STEP_PIN = 20
    RIGHT_MOTOR_DIR_PIN = 19
    RIGHT_MOTOR_STEP_PIN = 26
    SLEEP_PIN = 21

    # Signal pulses Per Revolution
    SPR = 800

    # Motor steps to move 1 cm
    CM = 132


    # Time between signal pulses when driving
    FAST_DRIVING_DELAY = 0.0001
    SLOW_DRIVING_DELAY = 0.0005

    # Time between signal pulses when turning
    TURNING_DELAY = 0.00075

    MICRO_TURN_STEPS = 10

    # Degrees / OFFSET
    OFFSET = 30

    # strict_turn() constants
    STRICT_TURN_TURNING_ANGLE = 90

    LEFT_STRICT_TURN_FORWARD_OFFSET = 2
    LEFT_STRICT_TURN_BACKWARD_OFFSET = 2

    RIGHT_STRICT_TURN_FORWARD_OFFSET = 1
    RIGHT_STRICT_TURN_BACKWARD_OFFSET = 2


class IMU_Constants:
    I2C_BUS = 1
    DEVICE_ADDRESS = 0x68

    CALIBRATION_PASSTHROUGHS = 3
    CALIBRATION_DATA_FILE = "calibration_values.txt"

    DMP_INITIALIZATION_TIMEOUT = 20
    LOOP_TIMEOUT = 0.001


class IR_Receiver_Constants:
    BUTTON_KEYS = [
        "61184", 
        "61185", 
        "61186", 
        "61187",
        "61188", 
        "61189", 
        "61190", 
        "61191", 
        "61192", 
        "61193", 
        "61194", 
        "61195", 
        "61196",
        "61197", 
        "61198",
        "61199", 
        "61200", 
        "61201", 
        "61202", 
        "61203", 
        "61204", 
        "61205", 
        "61206", 
        "61207"
    ]

    MAIN_KEYBINDS = {
        "61184": "Autonomous",
        "61185": "Manual",
        "61186": "Stop",
        "61187": "Start",
        "61191": "Clear the map",
    }

    AUTONOMOUS_MODE_KEYBINDS = {
        "61188": "Explore",
        "61189": "Find a bottle",
        "61190": "Return to home",
        "61195": "Clear queue",
        "61192": "Play a song"
    }

    MANUAL_MODE_KEYBINDS = {
        "61196": "Left micro turn",
        "61197": "Forward",
        "61198": "Right micro turn",
        "61200": "Left",
        "61201": "Stop",
        "61202": "Right",
        "61205": "Backward"
    }

    MAIN_KEYBINDS_BEEP_LENGTH = 0.3
    AUTONOMOUS_MODE_KEYBINDS_BEEP_LENGTH = 0.1
    MANUAL_MODE_KEYBINDS_BEEP_LENGTH = 0.1

    LAST_BUTTON_PRESS_TIMEOUT = 0.5
    LOOP_TIMEOUT = 0.1


class Map_Constants:
    TILE_SIZE = 6

    VISION_RANGE = 5
    OBSTACLE_CHECKING_RANGE = 7
    VISITED_TILES_CHECKING_RANGE = 5


class Robot_Constants:
    # 'f' = front, 'b' = back, 'l' = left, 'r' = right
    DIRECTIONS = ['f', 'b', 'l', 'r']

    MINIMUM_COLLISION_DETECTION_ANGLE = 1
    COLLISION_CHECKING_FREQUENCY = round(Drivetrain_Constants.CM / 8)

    LOOP_TIMEOUT = 0.1


class Sensing_System_Constants:
    FRONT_SENSOR_TRIG_PIN = 24
    FRONT_SENSOR_ECHO_PIN = 23

    REAR_SENSOR_TRIG_PIN = 14
    REAR_SENSOR_ECHO_PIN = 15

    LEFT_SENSOR_TRIG_PIN = 25
    LEFT_SENSOR_ECHO_PIN = 8

    RIGHT_SENSOR_TRIG_PIN = 7
    RIGHT_SENSOR_ECHO_PIN = 12

    # Values in cm
    MIN_FRONT_DISTANCE = 12
    MIN_BACK_DISTANCE = 16
    MIN_LEFT_DISTANCE = 16
    MIN_RIGHT_DISTANCE = 16
    SIDE_SENSOR_OFFSET = 3


# Author: Geir Istad
class MPU_Constants:
    MPU6050_ADDRESS_AD0_LOW = 0x68  # address pin low (GND), default
    MPU6050_ADDRESS_AD0_HIGH = 0x69  # address pin high (VCC)
    MPU6050_DEFAULT_ADDRESS = MPU6050_ADDRESS_AD0_LOW

    # [7] PWR_MODE, [6:1] XG_OFFS_TC, [0] OTP_BNK_VLD
    MPU6050_RA_XG_OFFS_TC = 0x00
    # [7] PWR_MODE, [6:1] YG_OFFS_TC, [0] OTP_BNK_VLD
    MPU6050_RA_YG_OFFS_TC = 0x01
    # [7] PWR_MODE, [6:1] ZG_OFFS_TC, [0] OTP_BNK_VLD
    MPU6050_RA_ZG_OFFS_TC = 0x02
    # [7:0] X_FINE_GAIN
    MPU6050_RA_X_FINE_GAIN = 0x03
    # [7:0] Y_FINE_GAIN
    MPU6050_RA_Y_FINE_GAIN = 0x04
    # [7:0] Z_FINE_GAIN
    MPU6050_RA_Z_FINE_GAIN = 0x05
    # [15:0] XA_OFFS
    MPU6050_RA_XA_OFFS_H = 0x06
    MPU6050_RA_XA_OFFS_L_TC = 0x07
    # [15:0] YA_OFFS
    MPU6050_RA_YA_OFFS_H = 0x08
    MPU6050_RA_YA_OFFS_L_TC = 0x09
    # [15:0] ZA_OFFS
    MPU6050_RA_ZA_OFFS_H = 0x0A
    MPU6050_RA_ZA_OFFS_L_TC = 0x0B
    # [15:0] XG_OFFS_USR
    MPU6050_RA_XG_OFFS_USRH = 0x13
    MPU6050_RA_XG_OFFS_USRL = 0x14
    # [15:0] YG_OFFS_USR
    MPU6050_RA_YG_OFFS_USRH = 0x15
    MPU6050_RA_YG_OFFS_USRL = 0x16
    # [15:0] ZG_OFFS_USR
    MPU6050_RA_ZG_OFFS_USRH = 0x17
    MPU6050_RA_ZG_OFFS_USRL = 0x18
    MPU6050_RA_SMPLRT_DIV = 0x19
    MPU6050_RA_CONFIG = 0x1A
    MPU6050_RA_GYRO_CONFIG = 0x1B
    MPU6050_RA_ACCEL_CONFIG = 0x1C
    MPU6050_RA_FF_THR = 0x1D
    MPU6050_RA_FF_DUR = 0x1E
    MPU6050_RA_MOT_THR = 0x1F
    MPU6050_RA_MOT_DUR = 0x20
    MPU6050_RA_ZRMOT_THR = 0x21
    MPU6050_RA_ZRMOT_DUR = 0x22
    MPU6050_RA_FIFO_EN = 0x23
    MPU6050_RA_I2C_MST_CTRL = 0x24
    MPU6050_RA_I2C_SLV0_ADDR = 0x25
    MPU6050_RA_I2C_SLV0_REG = 0x26
    MPU6050_RA_I2C_SLV0_CTRL = 0x27
    MPU6050_RA_I2C_SLV1_ADDR = 0x28
    MPU6050_RA_I2C_SLV1_REG = 0x29
    MPU6050_RA_I2C_SLV1_CTRL = 0x2A
    MPU6050_RA_I2C_SLV2_ADDR = 0x2B
    MPU6050_RA_I2C_SLV2_REG = 0x2C
    MPU6050_RA_I2C_SLV2_CTRL = 0x2D
    MPU6050_RA_I2C_SLV3_ADDR = 0x2E
    MPU6050_RA_I2C_SLV3_REG = 0x2F
    MPU6050_RA_I2C_SLV3_CTRL = 0x30
    MPU6050_RA_I2C_SLV4_ADDR = 0x31
    MPU6050_RA_I2C_SLV4_REG = 0x32
    MPU6050_RA_I2C_SLV4_DO = 0x33
    MPU6050_RA_I2C_SLV4_CTRL = 0x34
    MPU6050_RA_I2C_SLV4_DI = 0x35
    MPU6050_RA_I2C_MST_STATUS = 0x36
    MPU6050_RA_INT_PIN_CFG = 0x37
    MPU6050_RA_INT_ENABLE = 0x38
    MPU6050_RA_DMP_INT_STATUS = 0x39
    MPU6050_RA_INT_STATUS = 0x3A
    MPU6050_RA_ACCEL_XOUT_H = 0x3B
    MPU6050_RA_ACCEL_XOUT_L = 0x3C
    MPU6050_RA_ACCEL_YOUT_H = 0x3D
    MPU6050_RA_ACCEL_YOUT_L = 0x3E
    MPU6050_RA_ACCEL_ZOUT_H = 0x3F
    MPU6050_RA_ACCEL_ZOUT_L = 0x40
    MPU6050_RA_TEMP_OUT_H = 0x41
    MPU6050_RA_TEMP_OUT_L = 0x42
    MPU6050_RA_GYRO_XOUT_H = 0x43
    MPU6050_RA_GYRO_XOUT_L = 0x44
    MPU6050_RA_GYRO_YOUT_H = 0x45
    MPU6050_RA_GYRO_YOUT_L = 0x46
    MPU6050_RA_GYRO_ZOUT_H = 0x47
    MPU6050_RA_GYRO_ZOUT_L = 0x48
    MPU6050_RA_EXT_SENS_DATA_00 = 0x49
    MPU6050_RA_EXT_SENS_DATA_01 = 0x4A
    MPU6050_RA_EXT_SENS_DATA_02 = 0x4B
    MPU6050_RA_EXT_SENS_DATA_03 = 0x4C
    MPU6050_RA_EXT_SENS_DATA_04 = 0x4D
    MPU6050_RA_EXT_SENS_DATA_05 = 0x4E
    MPU6050_RA_EXT_SENS_DATA_06 = 0x4F
    MPU6050_RA_EXT_SENS_DATA_07 = 0x50
    MPU6050_RA_EXT_SENS_DATA_08 = 0x51
    MPU6050_RA_EXT_SENS_DATA_09 = 0x52
    MPU6050_RA_EXT_SENS_DATA_10 = 0x53
    MPU6050_RA_EXT_SENS_DATA_11 = 0x54
    MPU6050_RA_EXT_SENS_DATA_12 = 0x55
    MPU6050_RA_EXT_SENS_DATA_13 = 0x56
    MPU6050_RA_EXT_SENS_DATA_14 = 0x57
    MPU6050_RA_EXT_SENS_DATA_15 = 0x58
    MPU6050_RA_EXT_SENS_DATA_16 = 0x59
    MPU6050_RA_EXT_SENS_DATA_17 = 0x5A
    MPU6050_RA_EXT_SENS_DATA_18 = 0x5B
    MPU6050_RA_EXT_SENS_DATA_19 = 0x5C
    MPU6050_RA_EXT_SENS_DATA_20 = 0x5D
    MPU6050_RA_EXT_SENS_DATA_21 = 0x5E
    MPU6050_RA_EXT_SENS_DATA_22 = 0x5F
    MPU6050_RA_EXT_SENS_DATA_23 = 0x60
    MPU6050_RA_MOT_DETECT_STATUS = 0x61
    MPU6050_RA_I2C_SLV0_DO = 0x63
    MPU6050_RA_I2C_SLV1_DO = 0x64
    MPU6050_RA_I2C_SLV2_DO = 0x65
    MPU6050_RA_I2C_SLV3_DO = 0x66
    MPU6050_RA_I2C_MST_DELAY_CTRL = 0x67
    MPU6050_RA_SIGNAL_PATH_RESET = 0x68
    MPU6050_RA_MOT_DETECT_CTRL = 0x69
    MPU6050_RA_USER_CTRL = 0x6A
    MPU6050_RA_PWR_MGMT_1 = 0x6B
    MPU6050_RA_PWR_MGMT_2 = 0x6C
    MPU6050_RA_BANK_SEL = 0x6D
    MPU6050_RA_MEM_START_ADDR = 0x6E
    MPU6050_RA_MEM_R_W = 0x6F
    MPU6050_RA_DMP_CFG_1 = 0x70
    MPU6050_RA_DMP_CFG_2 = 0x71
    MPU6050_RA_FIFO_COUNTH = 0x72
    MPU6050_RA_FIFO_COUNTL = 0x73
    MPU6050_RA_FIFO_R_W = 0x74
    MPU6050_RA_WHO_AM_I = 0x75

    MPU6050_TC_PWR_MODE_BIT = 7
    MPU6050_TC_OFFSET_BIT = 6
    MPU6050_TC_OFFSET_LENGTH = 6
    MPU6050_TC_OTP_BNK_VLD_BIT = 0

    MPU6050_VDDIO_LEVEL_VLOGIC = 0
    MPU6050_VDDIO_LEVEL_VDD = 1

    MPU6050_CFG_EXT_SYNC_SET_BIT = 5
    MPU6050_CFG_EXT_SYNC_SET_LENGTH = 3
    MPU6050_CFG_DLPF_CFG_BIT = 2
    MPU6050_CFG_DLPF_CFG_LENGTH = 3

    MPU6050_EXT_SYNC_DISABLED = 0x0
    MPU6050_EXT_SYNC_TEMP_OUT_L = 0x1
    MPU6050_EXT_SYNC_GYRO_XOUT_L = 0x2
    MPU6050_EXT_SYNC_GYRO_YOUT_L = 0x3
    MPU6050_EXT_SYNC_GYRO_ZOUT_L = 0x4
    MPU6050_EXT_SYNC_ACCEL_XOUT_L = 0x5
    MPU6050_EXT_SYNC_ACCEL_YOUT_L = 0x6
    MPU6050_EXT_SYNC_ACCEL_ZOUT_L = 0x7

    MPU6050_DLPF_BW_256 = 0x00
    MPU6050_DLPF_BW_188 = 0x01
    MPU6050_DLPF_BW_98 = 0x02
    MPU6050_DLPF_BW_42 = 0x03
    MPU6050_DLPF_BW_20 = 0x04
    MPU6050_DLPF_BW_10 = 0x05
    MPU6050_DLPF_BW_5 = 0x06

    MPU6050_GCONFIG_FS_SEL_BIT = 4
    MPU6050_GCONFIG_FS_SEL_LENGTH = 2

    MPU6050_GYRO_FS_250 = 0x00
    MPU6050_GYRO_FS_500 = 0x01
    MPU6050_GYRO_FS_1000 = 0x02
    MPU6050_GYRO_FS_2000 = 0x03

    MPU6050_ACONFIG_XA_ST_BIT = 7
    MPU6050_ACONFIG_YA_ST_BIT = 6
    MPU6050_ACONFIG_ZA_ST_BIT = 5
    MPU6050_ACONFIG_AFS_SEL_BIT = 4
    MPU6050_ACONFIG_AFS_SEL_LENGTH = 2
    MPU6050_ACONFIG_ACCEL_HPF_BIT = 2
    MPU6050_ACONFIG_ACCEL_HPF_LENGTH = 3

    MPU6050_ACCEL_FS_2 = 0x00
    MPU6050_ACCEL_FS_4 = 0x01
    MPU6050_ACCEL_FS_8 = 0x02
    MPU6050_ACCEL_FS_16 = 0x03

    MPU6050_DHPF_RESET = 0x00
    MPU6050_DHPF_5 = 0x01
    MPU6050_DHPF_2P5 = 0x02
    MPU6050_DHPF_1P25 = 0x03
    MPU6050_DHPF_0P63 = 0x04
    MPU6050_DHPF_HOLD = 0x07

    MPU6050_TEMP_FIFO_EN_BIT = 7
    MPU6050_XG_FIFO_EN_BIT = 6
    MPU6050_YG_FIFO_EN_BIT = 5
    MPU6050_ZG_FIFO_EN_BIT = 4
    MPU6050_ACCEL_FIFO_EN_BIT = 3
    MPU6050_SLV2_FIFO_EN_BIT = 2
    MPU6050_SLV1_FIFO_EN_BIT = 1
    MPU6050_SLV0_FIFO_EN_BIT = 0

    MPU6050_MULT_MST_EN_BIT = 7
    MPU6050_WAIT_FOR_ES_BIT = 6
    MPU6050_SLV_3_FIFO_EN_BIT = 5
    MPU6050_I2C_MST_P_NSR_BIT = 4
    MPU6050_I2C_MST_CLK_BIT = 3
    MPU6050_I2C_MST_CLK_LENGTH = 4

    MPU6050_CLOCK_DIV_348 = 0x0
    MPU6050_CLOCK_DIV_333 = 0x1
    MPU6050_CLOCK_DIV_320 = 0x2
    MPU6050_CLOCK_DIV_308 = 0x3
    MPU6050_CLOCK_DIV_296 = 0x4
    MPU6050_CLOCK_DIV_286 = 0x5
    MPU6050_CLOCK_DIV_276 = 0x6
    MPU6050_CLOCK_DIV_267 = 0x7
    MPU6050_CLOCK_DIV_258 = 0x8
    MPU6050_CLOCK_DIV_500 = 0x9
    MPU6050_CLOCK_DIV_471 = 0xA
    MPU6050_CLOCK_DIV_444 = 0xB
    MPU6050_CLOCK_DIV_421 = 0xC
    MPU6050_CLOCK_DIV_400 = 0xD
    MPU6050_CLOCK_DIV_381 = 0xE
    MPU6050_CLOCK_DIV_364 = 0xF

    MPU6050_I2C_SLV_RW_BIT = 7
    MPU6050_I2C_SLV_ADDR_BIT = 6
    MPU6050_I2C_SLV_ADDR_LENGTH = 7
    MPU6050_I2C_SLV_EN_BIT = 7
    MPU6050_I2C_SLV_BYTE_SW_BIT = 6
    MPU6050_I2C_SLV_REG_DIS_BIT = 5
    MPU6050_I2C_SLV_GRP_BIT = 4
    MPU6050_I2C_SLV_LEN_BIT = 3
    MPU6050_I2C_SLV_LEN_LENGTH = 4

    MPU6050_I2C_SLV4_RW_BIT = 7
    MPU6050_I2C_SLV4_ADDR_BIT = 6
    MPU6050_I2C_SLV4_ADDR_LENGTH = 7
    MPU6050_I2C_SLV4_EN_BIT = 7
    MPU6050_I2C_SLV4_INT_EN_BIT = 6
    MPU6050_I2C_SLV4_REG_DIS_BIT = 5
    MPU6050_I2C_SLV4_MST_DLY_BIT = 4
    MPU6050_I2C_SLV4_MST_DLY_LENGTH = 5

    MPU6050_MST_PASS_THROUGH_BIT = 7
    MPU6050_MST_I2C_SLV4_DONE_BIT = 6
    MPU6050_MST_I2C_LOST_ARB_BIT = 5
    MPU6050_MST_I2C_SLV4_NACK_BIT = 4
    MPU6050_MST_I2C_SLV3_NACK_BIT = 3
    MPU6050_MST_I2C_SLV2_NACK_BIT = 2
    MPU6050_MST_I2C_SLV1_NACK_BIT = 1
    MPU6050_MST_I2C_SLV0_NACK_BIT = 0

    MPU6050_INTCFG_INT_LEVEL_BIT = 7
    MPU6050_INTCFG_INT_OPEN_BIT = 6
    MPU6050_INTCFG_LATCH_INT_EN_BIT = 5
    MPU6050_INTCFG_INT_RD_CLEAR_BIT = 4
    MPU6050_INTCFG_FSYNC_INT_LEVEL_BIT = 3
    MPU6050_INTCFG_FSYNC_INT_EN_BIT = 2
    MPU6050_INTCFG_I2C_BYPASS_EN_BIT = 1
    MPU6050_INTCFG_CLKOUT_EN_BIT = 0

    MPU6050_INTMODE_ACTIVEHIGH = 0x00
    MPU6050_INTMODE_ACTIVELOW = 0x01

    MPU6050_INTDRV_PUSHPULL = 0x00
    MPU6050_INTDRV_OPENDRAIN = 0x01

    MPU6050_INTLATCH_50USPULSE = 0x00
    MPU6050_INTLATCH_WAITCLEAR = 0x01

    MPU6050_INTCLEAR_STATUSREAD = 0x00
    MPU6050_INTCLEAR_ANYREAD = 0x01

    MPU6050_INTERRUPT_FF_BIT = 7
    MPU6050_INTERRUPT_MOT_BIT = 6
    MPU6050_INTERRUPT_ZMOT_BIT = 5
    MPU6050_INTERRUPT_FIFO_OFLOW_BIT = 4
    MPU6050_INTERRUPT_I2C_MST_INT_BIT = 3
    MPU6050_INTERRUPT_PLL_RDY_INT_BIT = 2
    MPU6050_INTERRUPT_DMP_INT_BIT = 1
    MPU6050_INTERRUPT_DATA_RDY_BIT = 0

    # TODO: figure out what these actually do
    # UMPL source code is not very obivous
    MPU6050_DMPINT_5_BIT = 5
    MPU6050_DMPINT_4_BIT = 4
    MPU6050_DMPINT_3_BIT = 3
    MPU6050_DMPINT_2_BIT = 2
    MPU6050_DMPINT_1_BIT = 1
    MPU6050_DMPINT_0_BIT = 0

    MPU6050_MOTION_MOT_XNEG_BIT = 7
    MPU6050_MOTION_MOT_XPOS_BIT = 6
    MPU6050_MOTION_MOT_YNEG_BIT = 5
    MPU6050_MOTION_MOT_YPOS_BIT = 4
    MPU6050_MOTION_MOT_ZNEG_BIT = 3
    MPU6050_MOTION_MOT_ZPOS_BIT = 2
    MPU6050_MOTION_MOT_ZRMOT_BIT = 0

    MPU6050_DELAYCTRL_DELAY_ES_SHADOW_BIT = 7
    MPU6050_DELAYCTRL_I2C_SLV4_DLY_EN_BIT = 4
    MPU6050_DELAYCTRL_I2C_SLV3_DLY_EN_BIT = 3
    MPU6050_DELAYCTRL_I2C_SLV2_DLY_EN_BIT = 2
    MPU6050_DELAYCTRL_I2C_SLV1_DLY_EN_BIT = 1
    MPU6050_DELAYCTRL_I2C_SLV0_DLY_EN_BIT = 0

    MPU6050_PATHRESET_GYRO_RESET_BIT = 2
    MPU6050_PATHRESET_ACCEL_RESET_BIT = 1
    MPU6050_PATHRESET_TEMP_RESET_BIT = 0

    MPU6050_DETECT_ACCEL_ON_DELAY_BIT = 5
    MPU6050_DETECT_ACCEL_ON_DELAY_LENGTH = 2
    MPU6050_DETECT_FF_COUNT_BIT = 3
    MPU6050_DETECT_FF_COUNT_LENGTH = 2
    MPU6050_DETECT_MOT_COUNT_BIT = 1
    MPU6050_DETECT_MOT_COUNT_LENGTH = 2

    MPU6050_DETECT_DECREMENT_RESET = 0x0
    MPU6050_DETECT_DECREMENT_1 = 0x1
    MPU6050_DETECT_DECREMENT_2 = 0x2
    MPU6050_DETECT_DECREMENT_4 = 0x3

    MPU6050_USERCTRL_DMP_EN_BIT = 7
    MPU6050_USERCTRL_FIFO_EN_BIT = 6
    MPU6050_USERCTRL_I2C_MST_EN_BIT = 5
    MPU6050_USERCTRL_I2C_IF_DIS_BIT = 4
    MPU6050_USERCTRL_DMP_RESET_BIT = 3
    MPU6050_USERCTRL_FIFO_RESET_BIT = 2
    MPU6050_USERCTRL_I2C_MST_RESET_BIT = 1
    MPU6050_USERCTRL_SIG_COND_RESET_BIT = 0

    MPU6050_PWR1_DEVICE_RESET_BIT = 7
    MPU6050_PWR1_SLEEP_BIT = 6
    MPU6050_PWR1_CYCLE_BIT = 5
    MPU6050_PWR1_TEMP_DIS_BIT = 3
    MPU6050_PWR1_CLKSEL_BIT = 2
    MPU6050_PWR1_CLKSEL_LENGTH = 3

    MPU6050_CLOCK_INTERNAL = 0x00
    MPU6050_CLOCK_PLL_XGYRO = 0x01
    MPU6050_CLOCK_PLL_YGYRO = 0x02
    MPU6050_CLOCK_PLL_ZGYRO = 0x03
    MPU6050_CLOCK_PLL_EXT32K = 0x04
    MPU6050_CLOCK_PLL_EXT19M = 0x05
    MPU6050_CLOCK_KEEP_RESET = 0x07

    MPU6050_PWR2_LP_WAKE_CTRL_BIT = 7
    MPU6050_PWR2_LP_WAKE_CTRL_LENGTH = 2
    MPU6050_PWR2_STBY_XA_BIT = 5
    MPU6050_PWR2_STBY_YA_BIT = 4
    MPU6050_PWR2_STBY_ZA_BIT = 3
    MPU6050_PWR2_STBY_XG_BIT = 2
    MPU6050_PWR2_STBY_YG_BIT = 1
    MPU6050_PWR2_STBY_ZG_BIT = 0

    MPU6050_WAKE_FREQ_1P25 = 0x0
    MPU6050_WAKE_FREQ_2P5 = 0x1
    MPU6050_WAKE_FREQ_5 = 0x2
    MPU6050_WAKE_FREQ_10 = 0x3

    MPU6050_BANKSEL_PRFTCH_EN_BIT = 6
    MPU6050_BANKSEL_CFG_USER_BANK_BIT = 5
    MPU6050_BANKSEL_MEM_SEL_BIT = 4
    MPU6050_BANKSEL_MEM_SEL_LENGTH = 5

    MPU6050_WHO_AM_I_BIT = 6
    MPU6050_WHO_AM_I_LENGTH = 6

    MPU6050_DMP_MEMORY_BANKS = 8
    MPU6050_DMP_MEMORY_BANK_SIZE = 256
    MPU6050_DMP_MEMORY_CHUNK_SIZE = 16

    # From MPU6050_6Axis_MotionApps20.h
    MPU6050_DMP_CODE_SIZE = 1929  # dmpMemory[]
    MPU6050_DMP_CONFIG_SIZE = 192  # dmpConfig[]
    MPU6050_DMP_UPDATES_SIZE = 47  # dmpUpdates[]
    """
     * ================================================================================================ *
     | Default MotionApps v2.0 42-byte FIFO packet structure:                                           |
     |                                                                                                  |
     | [QUAT W][      ][QUAT X][      ][QUAT Y][      ][QUAT Z][      ][GYRO X][      ][GYRO Y][      ] |
     |   0   1   2   3   4   5   6   7   8   9  10  11  12  13  14  15  16  17  18  19  20  21  22  23  |
     |                                                                                                  |
     | [GYRO Z][      ][ACC X ][      ][ACC Y ][      ][ACC Z ][      ][      ]                         |
     |  24  25  26  27  28  29  30  31  32  33  34  35  36  37  38  39  40  41                          |
     * ================================================================================================ *
     """
    # dmpMemory has size MPU6050_DMP_CODE_SIZE = 1929
    dmpMemory = [
        # bank 0, 256 bytes
        0xFB, 0x00, 0x00, 0x3E, 0x00, 0x0B, 0x00, 0x36, 0x00, 0x01, 0x00, 0x02,
        0x00, 0x03, 0x00, 0x00,
        0x00, 0x65, 0x00, 0x54, 0xFF, 0xEF, 0x00, 0x00, 0xFA, 0x80, 0x00, 0x0B,
        0x12, 0x82, 0x00, 0x01,
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
        0xA3, 0xB2, 0xA3, 0xA3, 0xA3, 0xA3, 0xA3, 0xA3, 0xB0, 0x87, 0xB5, 0x99,
        0xF1, 0xA3, 0xA3, 0xA3,
        0x98, 0xF1, 0xA3, 0xA3, 0xA3, 0xA3, 0x97, 0xA3, 0xA3, 0xA3, 0xA3, 0xF3,
        0x9B, 0xA3, 0xA3, 0xDC,
        0xB9, 0xA7, 0xF1, 0x26, 0x26, 0x26, 0xD8, 0xD8, 0xFF]

    # dmpConfig has size MPU6050_DMP_CONFIG_SIZE = 192
    dmpConfig = [
        #  BANK    OFFSET  LENGTH  [DATA]
        0x03, 0x7B, 0x03, 0x4C, 0xCD, 0x6C,  # FCFG_1 inv_set_gyro_calibration
        0x03, 0xAB, 0x03, 0x36, 0x56, 0x76,  # FCFG_3 inv_set_gyro_calibration
        0x00, 0x68, 0x04, 0x02, 0xCB, 0x47, 0xA2,
        # D_0_104 inv_set_gyro_calibration
        0x02, 0x18, 0x04, 0x00, 0x05, 0x8B, 0xC1,
        # D_0_24 inv_set_gyro_calibration
        0x01, 0x0C, 0x04, 0x00, 0x00, 0x00, 0x00,
        # D_1_152 inv_set_accel_calibration
        0x03, 0x7F, 0x06, 0x0C, 0xC9, 0x2C, 0x97, 0x97, 0x97,
        # FCFG_2 inv_set_accel_calibration
        0x03, 0x89, 0x03, 0x26, 0x46, 0x66,  # FCFG_7 inv_set_accel_calibration
        0x00, 0x6C, 0x02, 0x20, 0x00,  # D_0_108 inv_set_accel_calibration
        0x02, 0x40, 0x04, 0x00, 0x00, 0x00, 0x00,
        # CPASS_MTX_00 inv_set_compass_calibration
        0x02, 0x44, 0x04, 0x00, 0x00, 0x00, 0x00,  # CPASS_MTX_01
        0x02, 0x48, 0x04, 0x00, 0x00, 0x00, 0x00,  # CPASS_MTX_02
        0x02, 0x4C, 0x04, 0x00, 0x00, 0x00, 0x00,  # CPASS_MTX_10
        0x02, 0x50, 0x04, 0x00, 0x00, 0x00, 0x00,  # CPASS_MTX_11
        0x02, 0x54, 0x04, 0x00, 0x00, 0x00, 0x00,  # CPASS_MTX_12
        0x02, 0x58, 0x04, 0x00, 0x00, 0x00, 0x00,  # CPASS_MTX_20
        0x02, 0x5C, 0x04, 0x00, 0x00, 0x00, 0x00,  # CPASS_MTX_21
        0x02, 0xBC, 0x04, 0x00, 0x00, 0x00, 0x00,  # CPASS_MTX_22
        0x01, 0xEC, 0x04, 0x00, 0x00, 0x40, 0x00,
        # D_1_236 inv_apply_endian_accel
        0x03, 0x7F, 0x06, 0x0C, 0xC9, 0x2C, 0x97, 0x97, 0x97,
        # FCFG_2 inv_set_mpu_sensors
        0x04, 0x02, 0x03, 0x0D, 0x35, 0x5D,
        # CFG_MOTION_BIAS inv_turn_on_bias_from_no_motion
        0x04, 0x09, 0x04, 0x87, 0x2D, 0x35, 0x3D,  # FCFG_5 inv_set_bias_update
        0x00, 0xA3, 0x01, 0x00,  # D_0_163 inv_set_dead_zone
        # SPECIAL 0x01 = enable interrupts
        0x00, 0x00, 0x00, 0x01,  # SET INT_ENABLE at i=22, SPECIAL INSTRUCTION
        0x07, 0x86, 0x01, 0xFE,  # CFG_6 inv_set_fifo_interupt
        0x07, 0x41, 0x05, 0xF1, 0x20, 0x28, 0x30, 0x38,
        # CFG_8 inv_send_quaternion
        0x07, 0x7E, 0x01, 0x30,  # CFG_16 inv_set_footer
        0x07, 0x46, 0x01, 0x9A,  # CFG_GYRO_SOURCE inv_send_gyro
        0x07, 0x47, 0x04, 0xF1, 0x28, 0x30, 0x38,
        # CFG_9 inv_send_gyro -> inv_construct3_fifo
        0x07, 0x6C, 0x04, 0xF1, 0x28, 0x30, 0x38,
        # CFG_12 inv_send_accel -> inv_construct3_fifo
        0x02, 0x16, 0x02, 0x00, 0x01]  # D_0_22 inv_set_fifo_rate

    # This very last 0x01 WAS a 0x09, which drops the FIFO rate down to 20 Hz.
    # 0x07 is 25 Hz, 0x01 is 100Hz. Going faster than 100Hz (0x00=200Hz) tends
    # to result in very noisy data. DMP output frequency is calculated easily
    # using this equation: (200Hz / (1 + value))

    # It is important to make sure the host processor can keep up with reading
    # and processing the FIFO output at the desired rate. Handling FIFO overflow
    # cleanly is also a good idea.

    # dmpUpdates has size MPU6050_DMP_UPDATES_SIZE = 47
    dmpUpdates = [
        0x01, 0xB2, 0x02, 0xFF, 0xFF,
        0x01, 0x90, 0x04, 0x09, 0x23, 0xA1, 0x35,
        0x01, 0x6A, 0x02, 0x06, 0x00,
        0x01, 0x60, 0x08, 0x00, 0x00, 0x00, 0x00, 0x00, 0x00, 0x00, 0x00,
        0x00, 0x60, 0x04, 0x40, 0x00, 0x00, 0x00,
        0x01, 0x62, 0x02, 0x00, 0x00,
        0x00, 0x60, 0x04, 0x00, 0x40, 0x00, 0x00]
