gryxay/Rover/(commit log)

2022-09-16 Uploaded a file.
    [time_logs.xlsx]
2022-09-22 Updated the timelogs
    [time_logs.xlsx]
2022-09-29 Updated the time logs
    [time_logs.xlsx]
2022-10-05 Updated time_logs.xlsx
    [time_logs.xlsx]
2022-10-12 Tidied up doc directory
    [hardware_diagram.fzz]
2022-10-18 Uploaded the source code used for controling two stepper motors at the same time
2022-10-24 Uploaded motor mount models
    [motor_mount_2d.dwg, motor_mount_3d.dwg, motor_mount_3d.stl]
2022-10-24 Uploaded geared wheel models
    [gearded_wheel_3d.stl, geared_wheel_2d.dwg, geared_wheel_3d.dwg]
2022-10-24 Uploaded front motor mount models
    [front_wheel_mount_2d.dwg, front_wheel_mount_3d.dwg, front_wheel_mount_3d.stl]
2022-10-24 Created a new directory
    [front_wheel_mount_2d.dwg, front_wheel_mount_3d.dwg, front_wheel_mount_3d.stl, gearded_wheel_3d.stl, geared_wheel_2d.dwg, geared_wheel_3d.dwg, motor_mount_2d.dwg, motor_mount_3d.dwg]
2022-10-24 Removed file duplicates
    [front_wheel_mount_2d.dwg, front_wheel_mount_3d.dwg, front_wheel_mount_3d.stl, gearded_wheel_3d.stl, geared_wheel_2d.dwg, geared_wheel_3d.dwg, motor_mount_2d.dwg, motor_mount_3d.dwg]
2022-10-24 Uploaded front wheel mount models
    [front_wheel_mount.dwg, front_wheel_mount.stl]
2022-10-24 Uploaded rear wheel mount models
    [rear_wheel_mount.dwg, rear_wheel_mount.stl]
2022-10-24 Renamed a directory
    [front_wheel_mount_2d.dwg, front_wheel_mount_3d.dwg, front_wheel_mount_3d.stl]
2022-10-27 Uploaded gear test models
    [gear_test.dwg, gear_test.stl]
2022-10-28 Uploaded base plate models
    [base_plate_sketch_v1.dwg, base_plate_v1.stl]
2022-10-28 Uploaded wheel mount models
    [front_wheel_mount_2d.dwg, front_wheel_mount_3d.dwg, front_wheel_mount_sketch_v1.dwg, front_wheel_mount_sketch_v2.dwg, front_wheel_mount_v2.stl, rear_wheel_mount_sketch_v1.dwg, rear_wheel_mount_v1.stl]
2022-11-02 Uploaded prototype models
    [base_plate_sketch_v1.dwg, computer_plate.stl, computer_plate_sketch_v1.dwg, front_wheel_mount_3d.stl, front_wheel_mount_left_v4.stl, front_wheel_mount_right_v4.stl, front_wheel_mount_sketch_v2.dwg, front_wheel_mount_sketch_v2.stl]
2022-11-04 Uploaded sensor mount models
    [sensor_mount.dwg, sensor_mount.stl]
2022-11-04 Uploaded sensor case models
    [sensor_case.dwg, sensor_case.stl]
2022-11-04 Uploaded front left sensor mount models
    [front_left_sensor_mount.dwg, front_left_sensor_mount.stl]
2022-11-04 Uploaded front right sensor mount models
    [front_right_sensor_mount.dwg, front_right_sensor_mount.stl]
2022-11-06 camera_mount/a
    Uploaded camera mount models
    [camera_mount_b.stl, camera_mount_sketch_b.dwg]
2022-11-06 Uploaded motor controller mount models
    [motor_controller_mount.stl, motor_controller_mount_sketch.dwg]
2022-11-06 Uploaded battery holder mount models
    [battery_holder_mount.stl, battery_holder_mount_sketch.dwg]
2022-11-06 Uploaded power switch case models
    [power_switch_case.stl, power_switch_case_sketch.dwg]
2022-11-12 Prototype of double camera threading and calculating dispersity between 2 images
2022-11-20 Uploaded drivetrain tests used to measure driving precision
2022-11-22 Added the functionality of turning on/off motors
2022-11-22 Updated the python script used to test drivetrain functionality
2022-11-22 Fixed a bug
    [camera_mount_a.stl, camera_mount_sketch_a.dwg]
2022-11-22 Removed files
    [camera_mount_a.stl, camera_mount_sketch_a.dwg]
2022-11-22 Reuploaded previously removed files
    [camera_mount_a.stl, camera_mount_sketch_a.dwg]
2022-11-28 Uploaded compass calibration results graph
2022-11-28 Uploaded compass calibration scripts
2022-11-28 Uploaded a gnuplot script used for generating a graph out of compass calibration data.
2022-11-28 Uploaded files containing compass calibration data
2022-11-28 Uploaded a python class used for implementing the functionality of QMC5883L magnetometer
2022-11-28 Deleted timelogs
    [time_logs.xlsx]
2022-11-29 Uploaded scripts used for testing mpu6050 accelerometer/gyroscope module.
2022-12-03 Fixed a formatting mistake
    [distance_sensor.py]
2022-12-03 Uploaded a python script used to test accelerometer and gyroscope data output
2022-12-03 Uploaded a python script used to test roll, pitch and yaw data
2022-12-03 Changed the output format of yaw angle
2022-12-13 Update exploration_logic.py Adding missing functionality, and deleting unnecessary code
    [exploration_logic.py]
2022-12-13 Update exploration_logic.py fixing some errors and adding more functionality
    [exploration_logic.py]
2022-12-13 Added toggle_power() function and changed front sensor distance limit
2022-12-13 Update exploration_logic.py Fixed some bugs, Rover can now explore surroundings by following walls
    [exploration_logic.py]
2022-12-14 Updated the motor test
2022-12-14 Updated the drivetrain test
2022-12-14 Uploaded a file required for drivetrain testing
2022-12-14 Uploaded a distance sensor test
2022-12-14 Uploaded a file required for distance sensor testing
2022-12-14 Uploaded the final version of the base plate 3D model
    [base_plate_sketch_v1.dwg, base_plate_v1.stl]
2022-12-14 Uploaded the final version of the battery pack mount 3D model
    [battery_holder_mount.stl, battery_holder_mount_sketch.dwg]
2022-12-14 Uploaded the final version of the computer plate 3D model
    [computer_plate.stl, computer_plate_sketch.dwg]
2022-12-14 Renamed files
    [base_plate_sketch.dwg]
2022-12-14 Uploaded a file
    [base_plate.stl]
2022-12-14 Renamed a file
    [base_plate_sketch_v1.dwg]
2022-12-14 Removed a file
    [base_plate_sketch_v1.dwg]
2022-12-14 Uploaded the final version of distance sensor 3D model
    [sensor_case.dwg, sensor_case.stl, sensor_mount.dwg, sensor_mount.stl]
2022-12-14 Uploaded the final versions of front wheel mount 3D models
    [front_wheel_mount_left.stl, front_wheel_mount_right.stl]
2022-12-14 Uploaded the final version on geared wheel 3D model
    [geared_wheel.stl, geared_wheel_sketch.dwg]
2022-12-14 Uploaded the final version of motor controller mount 3D model
    [motor_controller_mount.stl, motor_controller_mount_sketch.dwg]
2022-12-14 Uploaded the final version of motor mount 3D models
    [motor_mount_left.stl, motor_mount_right.stl, motor_mount_sketch_left.dwg, motor_mount_sketch_right.dwg]
2022-12-14 Uploaded the final version of power switch case 3D model
    [power_switch_case.stl, power_switch_case_sketch.dwg]
2022-12-14 Uploaded the final version of power bank holder 3D mounts
    [power_bank_holder.stl, power_bank_holder_sketch.dwg]
2022-12-16 Uploaded left sensor mount 3D model
    [left_sensor_mount.stl]
2022-12-16 Uploaded right sensor mount 3D model
    [right_sensor_mount.stl]
2022-12-16 Uploaded side sensor mount sketch
    [side_sensor_mounts.dwg]
2022-12-16 Updated the 3D model
    [left_sensor_mount.stl]
2022-12-16 Updated the sketch
    [side_sensor_mounts.dwg]
2022-12-19 Uploaded an updated version of drivetrain.py
2022-12-19 Replace drivetrain.py
2022-12-21 Uploaded a new class called imu.py
2022-12-27 Uploaded a new (prototype) version on Map_tile class
2022-12-27 Uploaded a new (prototype) version on Map class
2022-12-28 Uploaded a deployed version of calibration_values.txt
2022-12-28 Uploaded a deployed version of Drivetrain.py
2022-12-28 Uploaded a deployed version of IMU.py
2022-12-28 Fixed a corrupted file
    [SimplePID.py]
2023-01-06 Fixed a deadlock causing errors
    [Distance_Sensor.py, Sensing_System.py]
2023-01-11 Uploaded a missing script
    [Sensing_System.py]
2023-01-11 Uploaded a missing file
    [Sensing_System.py]
2023-01-12 Uploaded config files
    [config.txt]
2023-01-12 Moved a directory
    [config.txt]
2023-01-12 Update src/development/python3.11/hardware_classes/mpu6050/MPU6050.py, src/development/python3.11/hardware_classes/mpu6050/MPUConstants.py, src/development/python3.11/hardware_classes/mpu6050/Quatern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
    [Buzzer.py, Compass.py, Computer_Vision.py, Constants.py, Distance_Sensor.py, Drivetrain.py, IMU.py, IR_Receiver.py]
2023-01-12 Uploaded IMU test
2023-01-12 Uploaded Motor test
2023-01-12 Uploaded Distance Sensor test
2023-01-12 Uploaded Drivetrain test
2023-01-12 Update comments in Drivetrain.py
